thephantom8768/Phantom-Macro-Mk.1-Series/README.md

# Phantom Macro Mk.1 Series

> A modular, snap-together macropad ecosystem with lateral pogo-pin bus interconnects.

Chain modules side-by-side to expand your desktop workflow—from a compact macro-pad into a full fledge keyboard.

---

## 📌 Project Status

- **Hardware:** Series still in-dev
- **Firmware:** Pad is almost complete but I need to built it to measure the adc. Others are still in-dev
- **Interconnect:** Custom edge-mount 8 pin pogo interface.

---

## ⚡ Features

- **Snap & Chain Topology:** Expand your layout horizontally by mating adjacent modules using edge-mounted pogo connectors.
- **Unified Bus Standard:** Standardized power, ground, and communication rails allow any Mk.1-series compatible module to hot-mate with the system.
- **Flexible Layouts:** Mix and match different form factors (numpads, macro clusters, encoder dials) without rerunning separate USB cables to your host machine.

## ⚠️ Build Warnings

> [!WARNING]
> **DIY Soldering Required:** This is a fully self-assembled project. It is not a plug-and-play kit and requires intermediate soldering experience.

* **Double-Sided Assembly:** Depending on the macro-pad, components might need to be soldered onto **both the top and bottom** of the PCB.

## *Mk.1 Series*

<details>
  <summary><b>🔢 Phantom-Macro-Mk.1 Pad (click here)</b></summary>
  
  ### Macro Mk.1 Pad
  
  #### Schematic

Phantom Macro Mk1 Pad

#### PCB Layout

4 Layers PCB

<div style="width: max; height: max; overflow: hidden; display: inline-block;">
  <a href="Pics/Pad/Phantom Macro Mk1 Pad Schematic.png" target="_blank">
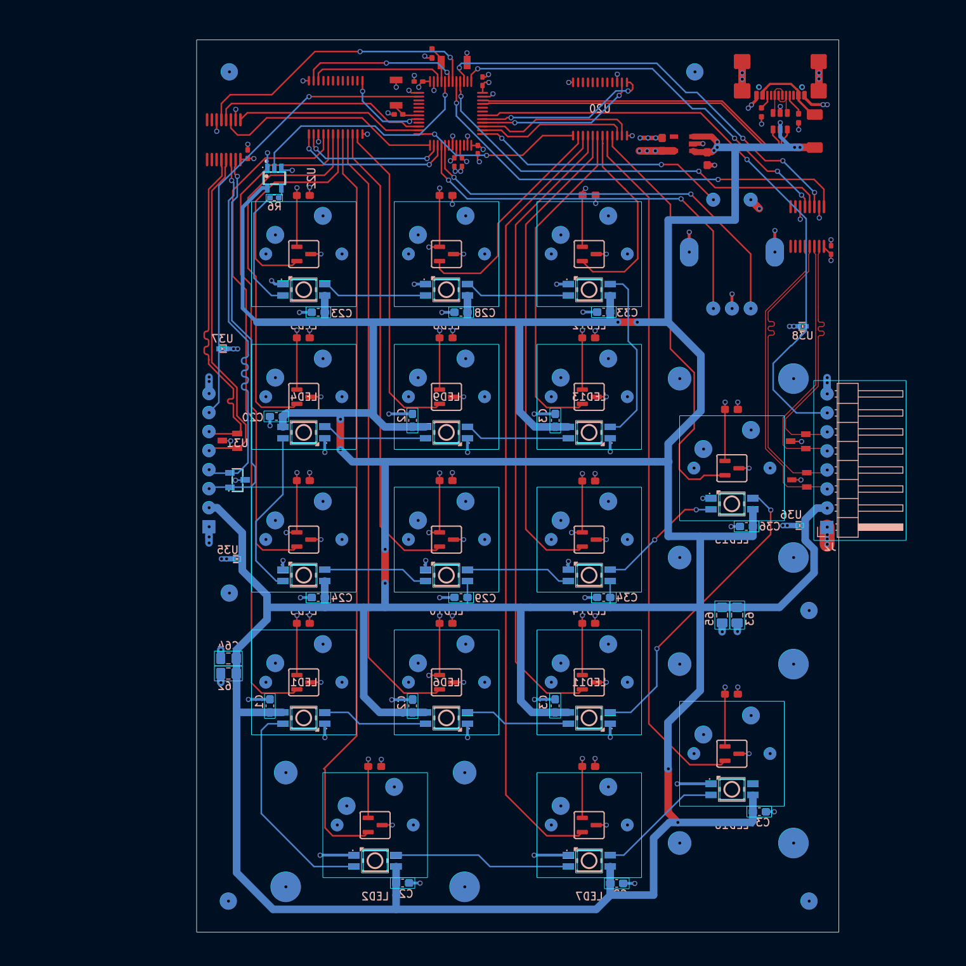
[picture p1: Pics/Pad/Phantom Macro Mk1 Pad Schematic.png]
    
  </a>
</div>

| Front (1st layer) | Bottom (4th layer) |
| --- | --- |
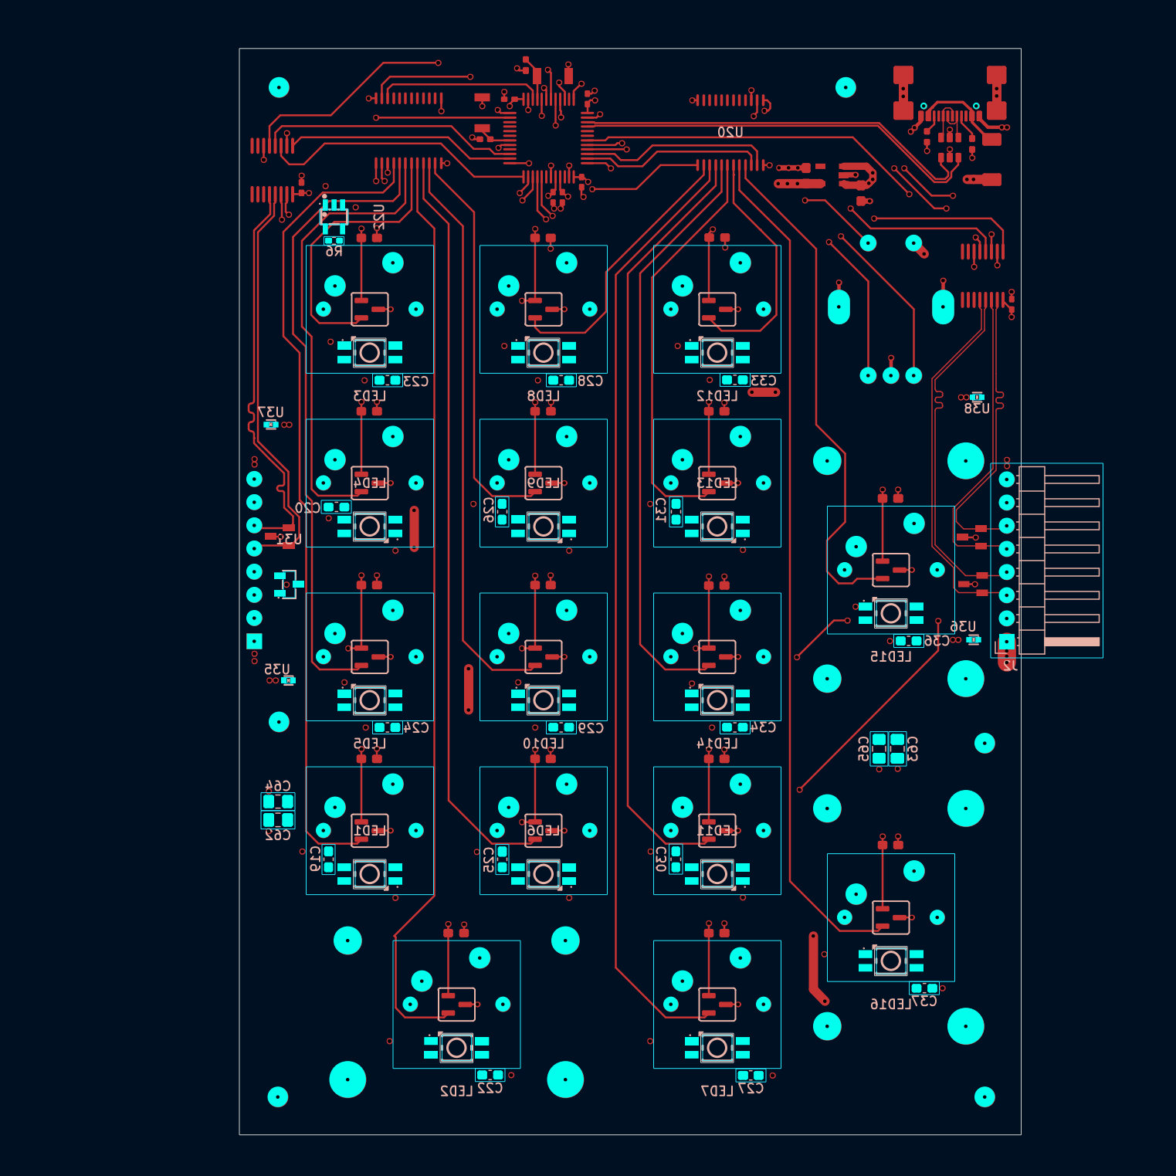
[picture p2: Pics/Pad/Phantom Macro Mk1 Pad Schematic Top.png]
Phantom Macro Mk1 pad Schematic Top
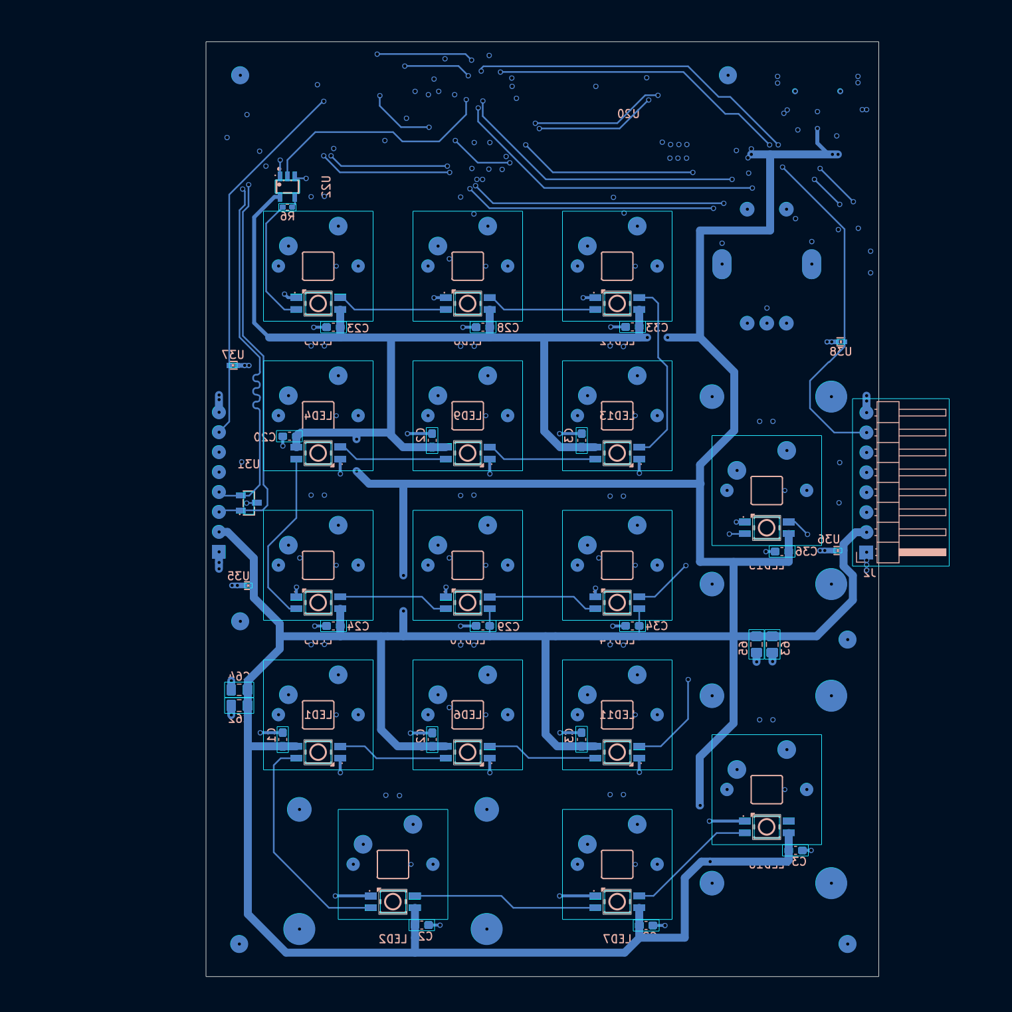
[picture p3: Pics/Pad/Phantom Macro Mk1 Pad Schematic Bottom.png]
Phantom Macro Mk1 Pad Schematic Bottom
|  |  |
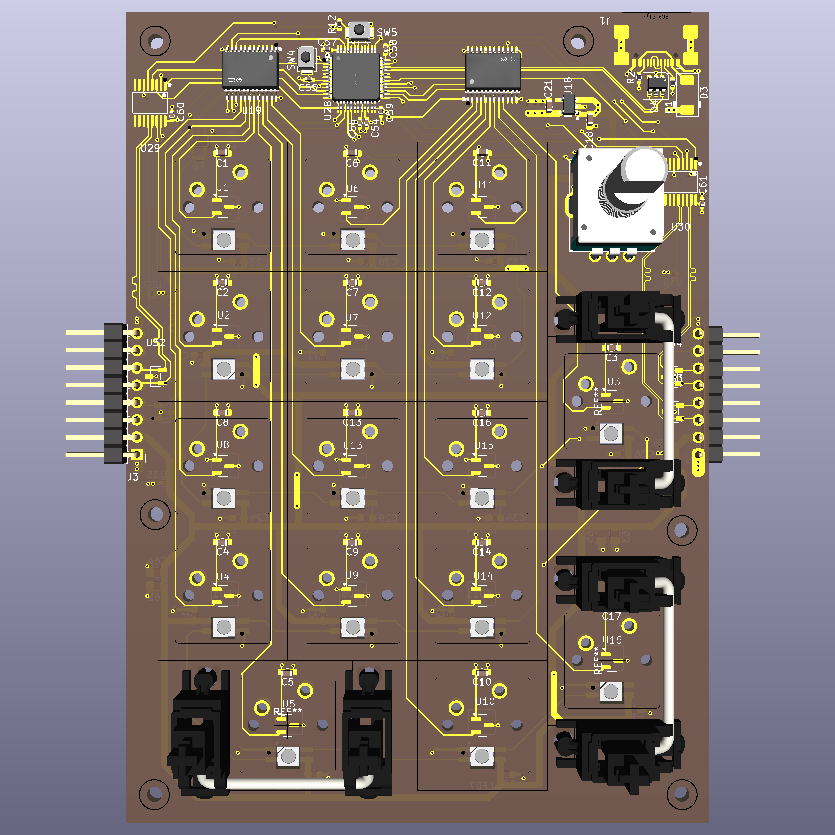
[picture p4: Pics/Pad/Phantom Macro Mk1 Pad Top Trace.png]
Phantom Macro Mk1 Pad Top Trace
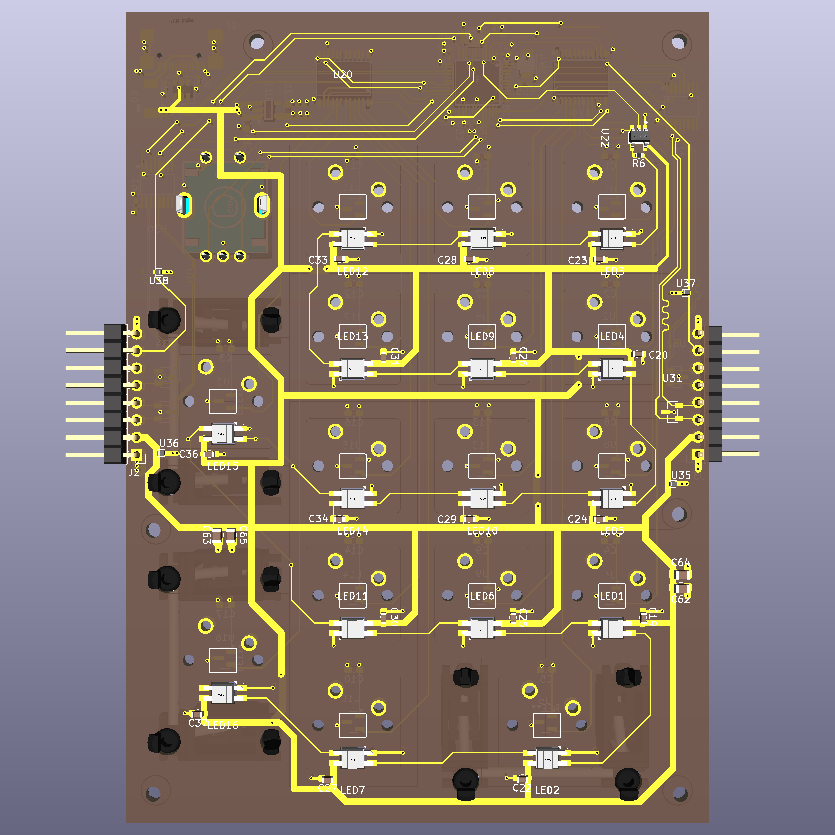
[picture p5: Pics/Pad/Phantom Macro Mk1 Pad Bottom Trace.png]
Phantom Macro Mk1 Pad Bottom Trace
|  |  |

#### PCB
| Front | Back |
| ----- | ---- |
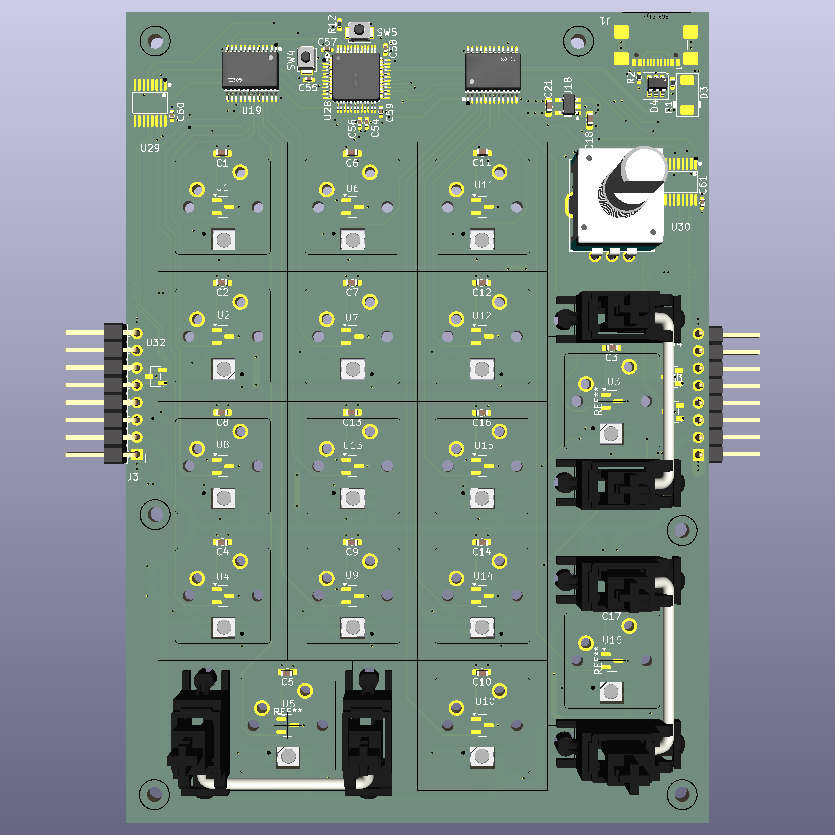
[picture p6: Pics/Pad/Phantom Macro Mk1 Pad Ortho3.png]
Phantom Macro Mk1 Ortho3
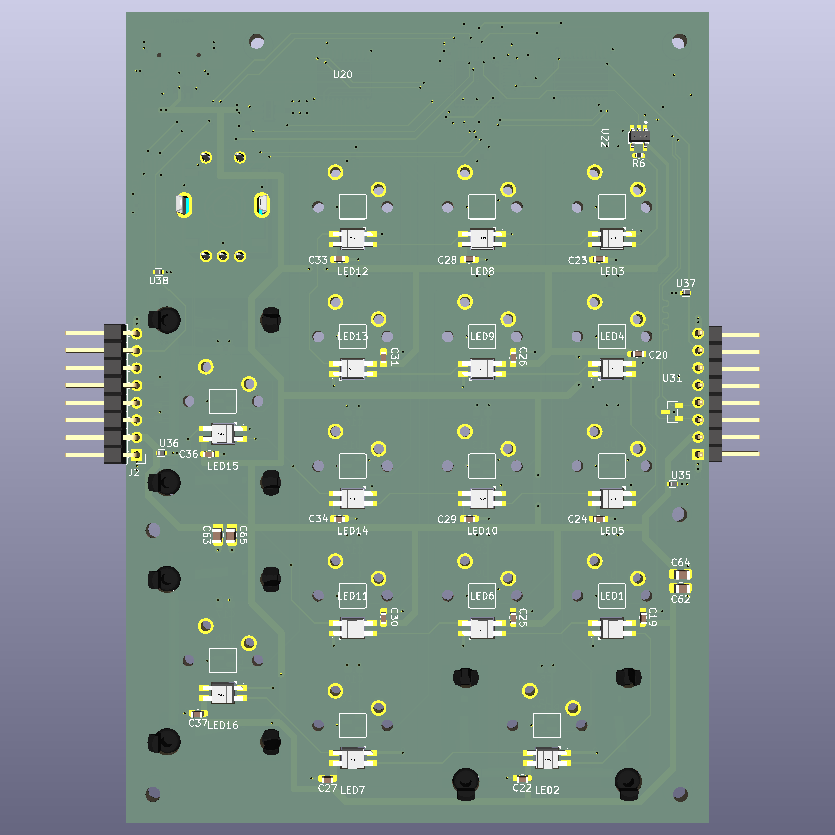
[picture p7: Pics/Pad/Phantom Macro Mk1 Pad Ortho4.png]
Phantom Macro Mk1 Ortho4
|  |  |
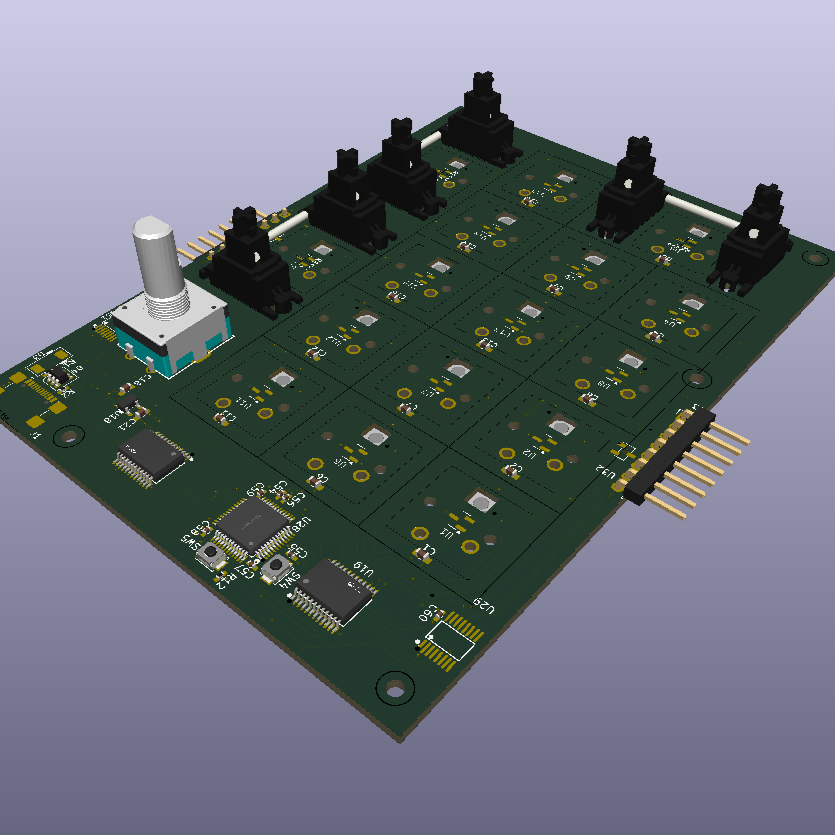
[picture p8: Pics/Pad/Phantom Macro Mk1 Pad Ortho1.png]
Phantom Macro Mk1 Ortho1
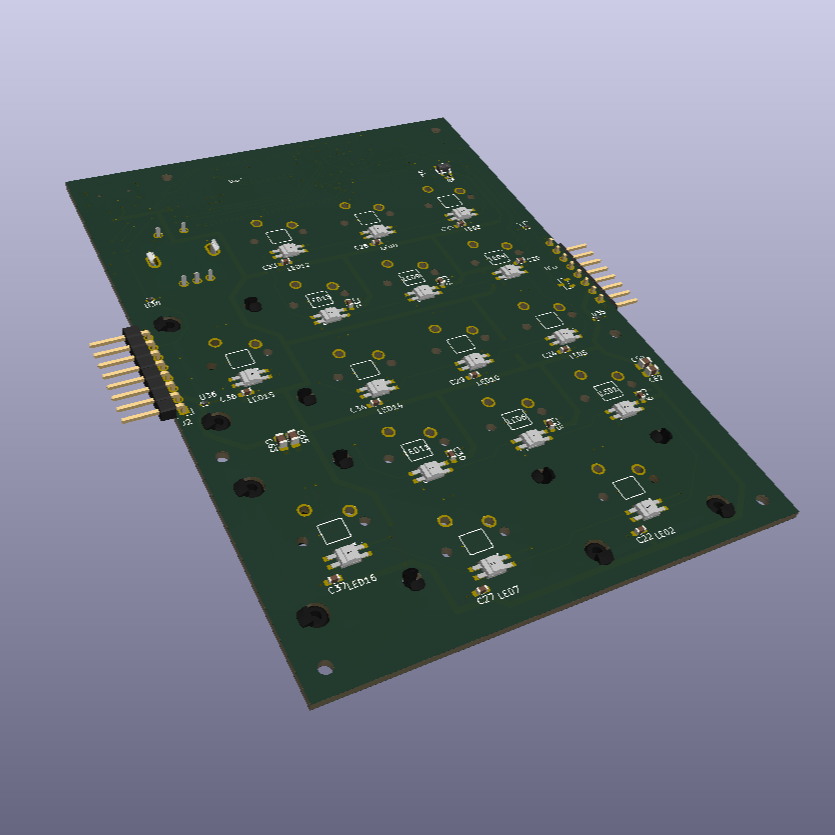
[picture p9: Pics/Pad/Phantom Macro Mk1 Pad Ortho2.png]
Phantom Macro Mk1 Ortho2
|  |  |

#### Case

<table>
  <tbody>
    <tr>
      <td width="50%">
        <a href="Pics/Pad/Case1.png" target="_blank">
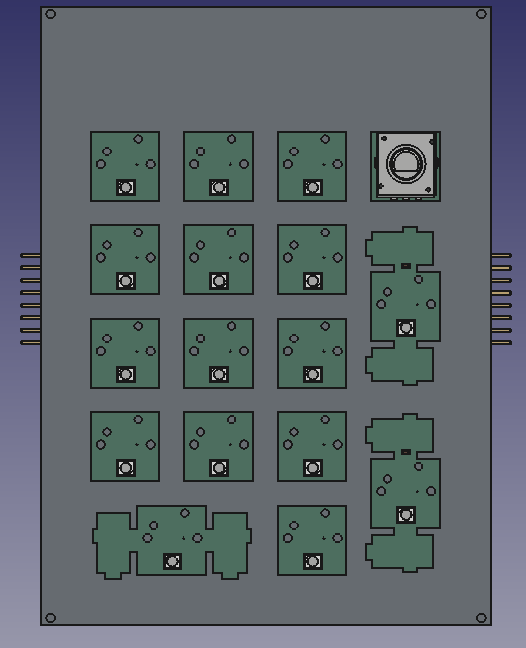
[picture p10: Pics/Pad/Case1.png]
Case 1 - Top Left
          
        </a>
      </td>
      <td width="50%">
        <a href="Pics/Pad/Case2.png" target="_blank">
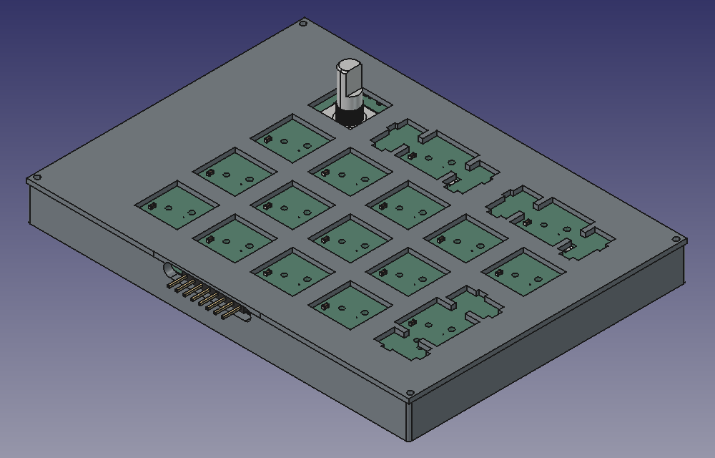
[picture p11: Pics/Pad/Case2.png]
Case 2 - Top Right
          
        </a>
      </td>
    </tr>
    <tr>
      <td width="50%">
        <a href="Pics/Pad/Case3.png" target="_blank">
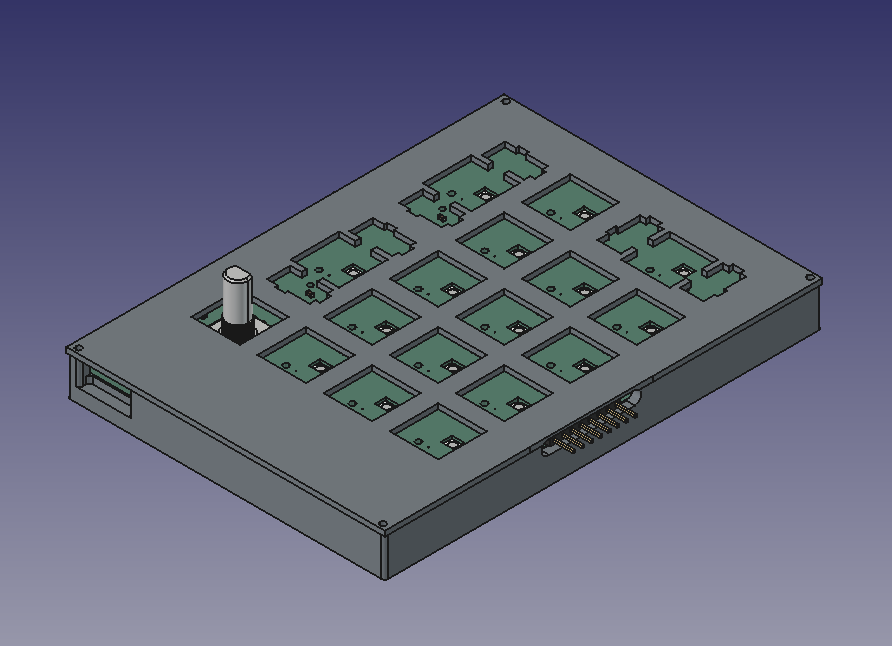
[picture p12: Pics/Pad/Case3.png]
Case 3 - Bottom Left
          
        </a>
      </td>
      <td width="50%">
        <a href="Pics/Pad/Case4.png" target="_blank">
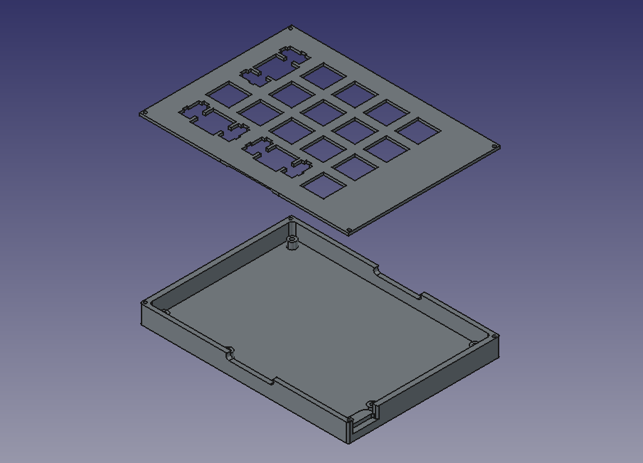
[picture p13: Pics/Pad/Case4.png]
Case 4 - Bottom Right
          
        </a>
      </td>
    </tr>
  </tbody>
</table>

</details>

<details>
  <summary><b>🎹 Phantom-Macro-Mk.1 MIDI (click here)</b></summary>
  
  ### Macro Mk.1 MIDI
  
  #### Schematic

  Phantom Macro Mk1 MIDI

  #### PCB Layout 

  2 Layers PCB
  
  Phantom Macro Mk1 MIDI Schematic

  | Front | Back |
  | ----- | ----- |
  | Phantom Macro Mk1 MIDI Schematic Top | PPhantom Macro Mk1 MIDI Schematic Bottom |
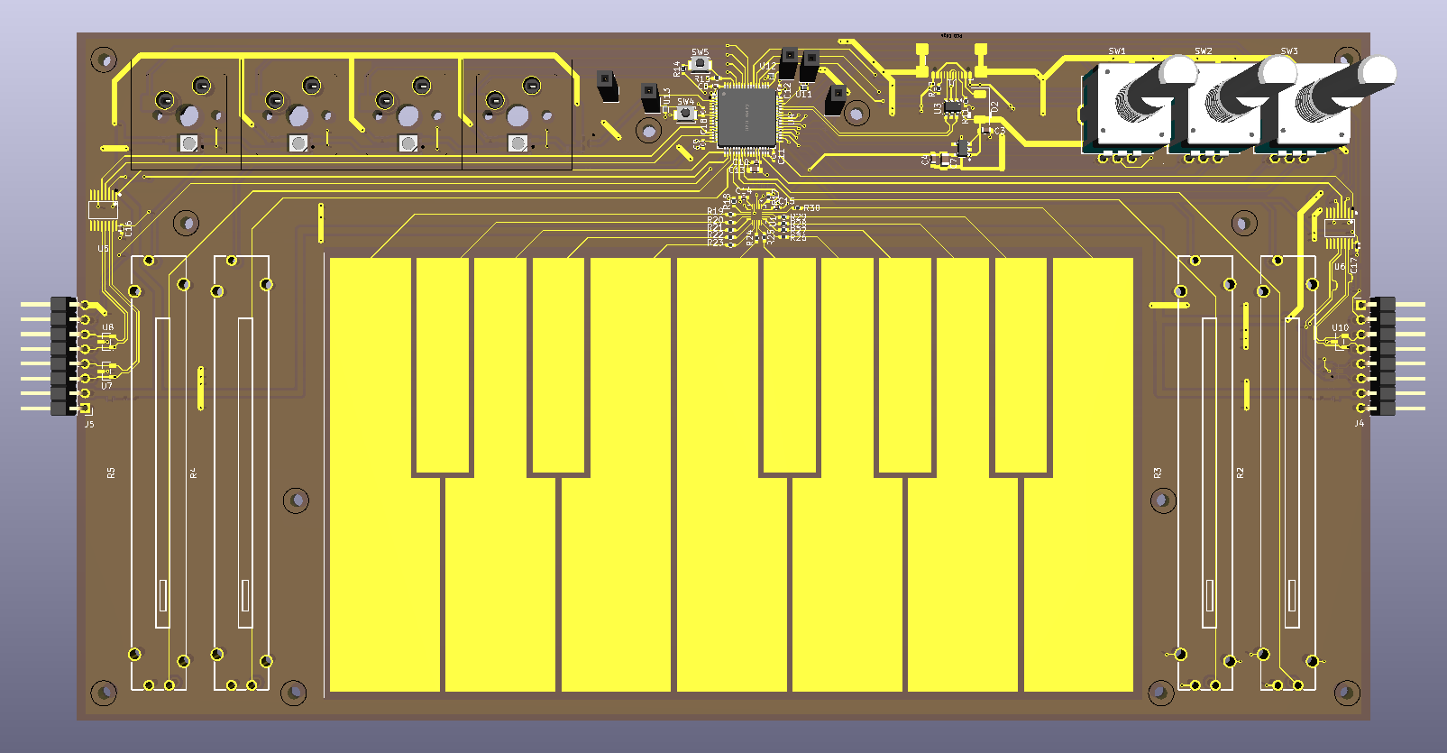
[picture p14: Pics/MIDI/Phantom Macro Mk1 MIDI Top Trace.png]
Phantom Macro Mk1 MIDI Top Trace
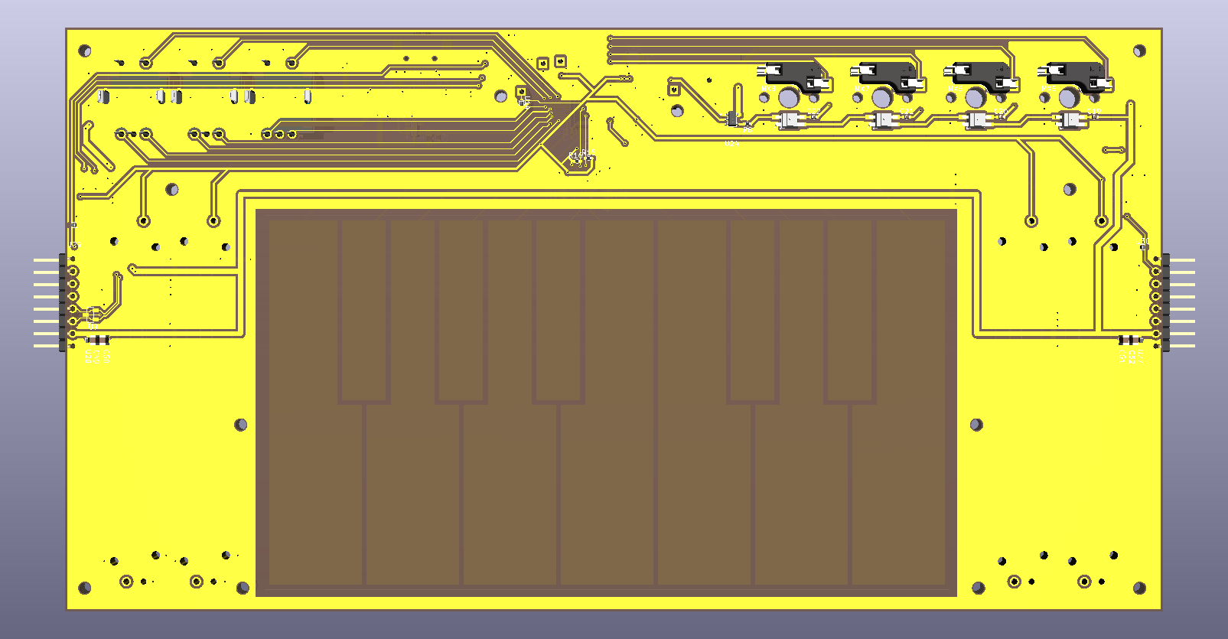
[picture p15: Pics/MIDI/Phantom Macro Mk1 MIDI Bottom Trace.png]
Phantom Macro Mk1 MIDI Bottom Trace
  |  |  |

  #### PCB
  | Front | Back |
  | ----- | ---- |
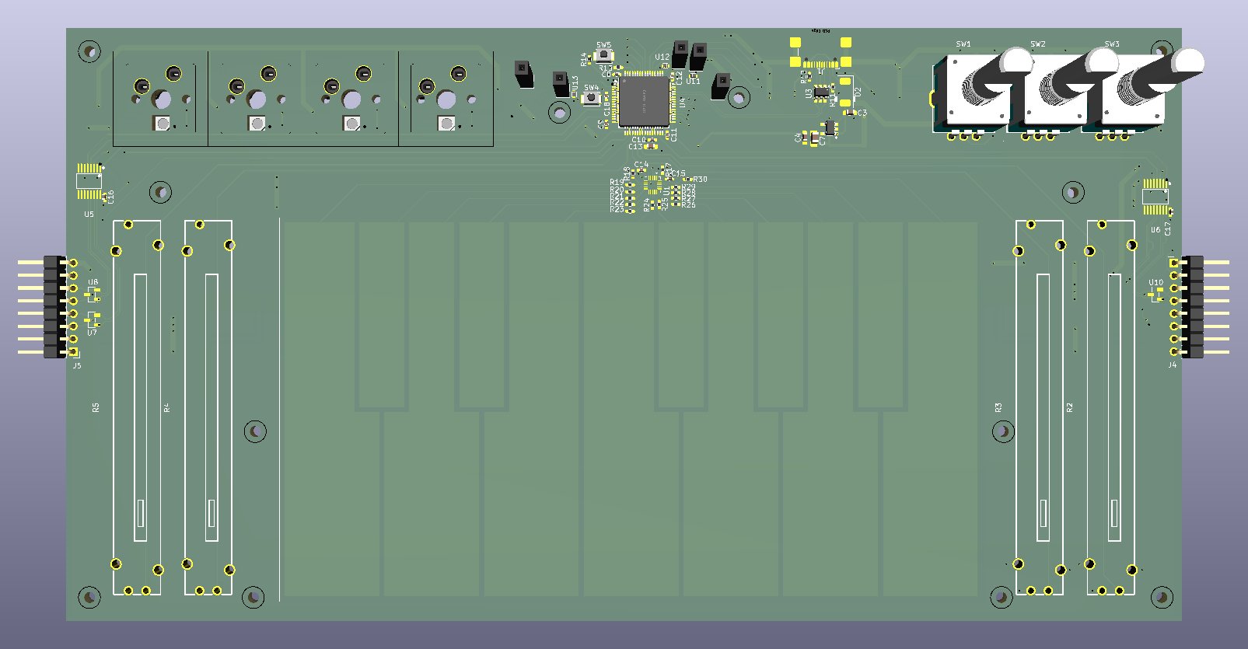
[picture p16: Pics/MIDI/Phantom Macro Mk1 MIDI Top.png]
Phantom Macro Mk1 MIDI Top
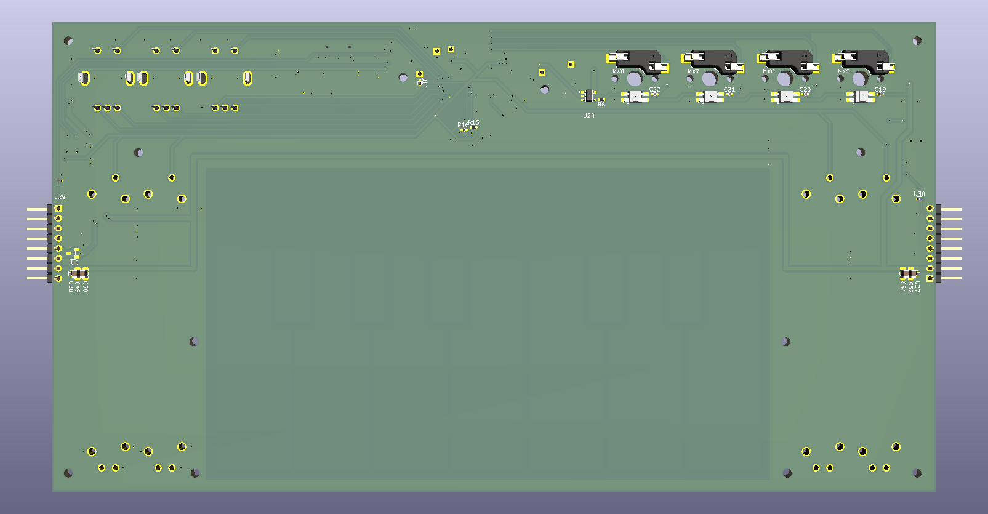
[picture p17: Pics/MIDI/Phantom Macro Mk1 MIDI Bottom.png]
Phantom Macro Mk1 MIDI Bottom
  |  |  |
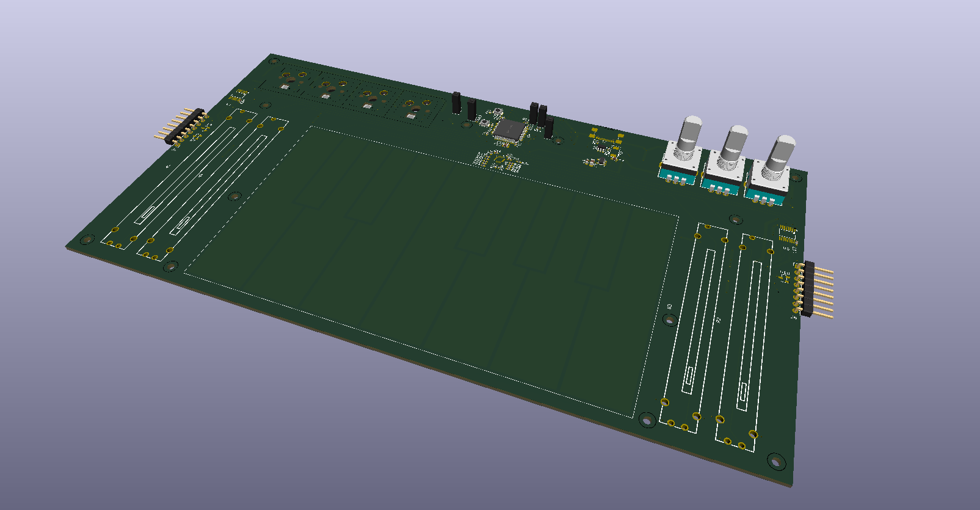
[picture p18: Pics/MIDI/Phantom Macro Mk1 MIDI ortho1.png]
Phantom Macro Mk1 MIDI ortho1
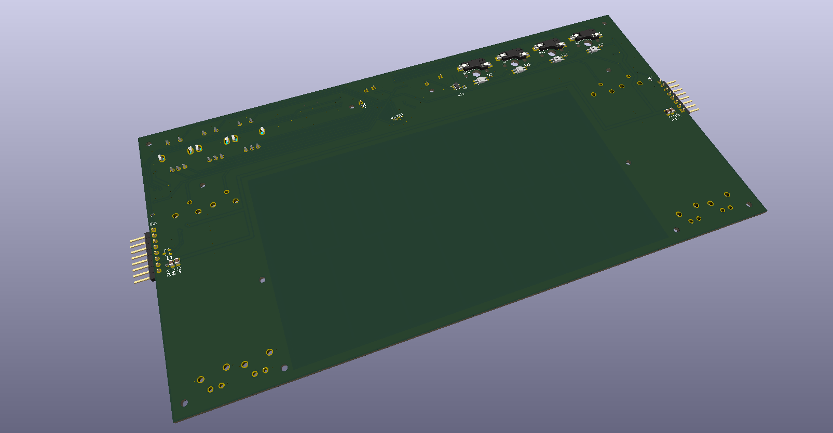
[picture p19: Pics/MIDI/Phantom Macro Mk1 MIDI ortho2.png]
Phantom Macro Mk1 MIDI ortho2
  |  |  |

</details>
