thephantom8768/Phantom-Macro-Mk.1-Series/Kicad Files/MIDI/Phantom Macro Mk1 MIDI.csv

Reference | Qty | Value | DNP | Exclude from BOM | Exclude from Board | Footprint | Datasheet
C3,C4,C13 | 3 | 1uF |  |  |  | Capacitor_SMD:C_0603_1608Metric_Pad1.08x0.95mm_HandSolder
C7 | 1 | 4.7uF |  |  |  | Capacitor_SMD:C_0805_2012Metric_Pad1.18x1.45mm_HandSolder
C8,C9,C10,C11,C12,C14,C15,C16,C17,C18,C19,C20,C21,C22 | 14 | 100nF |  |  |  | Capacitor_SMD:C_0402_1005Metric_Pad0.74x0.62mm_HandSolder
C49,C52 | 2 | 0.1uF |  |  |  | Capacitor_SMD:C_0805_2012Metric_Pad1.18x1.45mm_HandSolder
C50,C51 | 2 | 10uF |  |  |  | Capacitor_SMD:C_0805_2012Metric_Pad1.18x1.45mm_HandSolder
D2 | 1 | PMEG3030EP |  |  |  | PCM_Diode_SMD_AKL:D_SOD-128 | https://www.tme.eu/Document/abe71b1e3ae43c8e032df0d278a6f86a/PMEG3030EP.115.pdf
J1 | 1 | USB_C_Receptacle_USB2.0_16P |  |  |  | Connector_USB:USB_C_Receptacle_GCT_USB4110 | https://www.usb.org/sites/default/files/documents/usb_type-c.zip
J2 | 1 | Conn_01x12 |  |  |  | Piano:7 key piano tiles
J3,J6,J7,J8,J9 | 5 | Conn_01x01 |  |  |  | Connector_PinSocket_2.54mm:PinSocket_1x01_P2.54mm_Vertical
J4,J5 | 2 | Conn_01x08 |  |  |  | Connector_PinHeader_2.54mm:PinHeader_1x08_P2.54mm_Horizontal
LED1,LED2,LED3,LED4 | 4 | SK6803MINI-E-001 |  |  |  | lcsc_shared_footprints:C5242955_LED-SMD_4P-L3_2-W2_8_SK6803MINI-E-001 | https://wmsc.lcsc.com/wmsc/upload/file/pdf/v2/lcsc/2211011500_OPSCO-Optoelectronics-SK6803MINI-E-001_C5242955.pdf
MX5,MX6,MX7,MX8 | 4 | MX_SW_HS |  |  |  | PCM_marbastlib-mx:SW_MX_HS_CPG151101S11_1u
R2,R3,R4,R5 | 4 | PTA6043-2015DPA103 |  |  |  | lcsc_shared_footprints:C17237498_RES-ADJ-TH_PTA6043-XXXX | https://wmsc.lcsc.com/wmsc/upload/file/pdf/v2/lcsc/2311050146_BOURNS-PTA6043-2015DPA103_C17237498.pdf
R8 | 1 | 47R |  |  |  | Resistor_SMD:R_0402_1005Metric_Pad0.72x0.64mm_HandSolder
R11,R12 | 2 | 5.2k |  |  |  | Resistor_SMD:R_0402_1005Metric_Pad0.72x0.64mm_HandSolder
R13,R17,R18 | 3 | 10k |  |  |  | Resistor_SMD:R_0402_1005Metric_Pad0.72x0.64mm_HandSolder
R14 | 1 | 100 |  |  |  | Resistor_SMD:R_0402_1005Metric_Pad0.72x0.64mm_HandSolder
R15,R16 | 2 | 4.7k |  |  |  | Resistor_SMD:R_0402_1005Metric_Pad0.72x0.64mm_HandSolder
R19,R20,R21,R22,R23,R24,R25,R26,R27,R28,R29,R30 | 12 | 2k |  |  |  | Resistor_SMD:R_0402_1005Metric_Pad0.72x0.64mm_HandSolder
SW1,SW2,SW3 | 3 | PEC11R-4020F-S0024 |  |  |  | lcsc_shared_footprints:C143788_SW-TH_5P-L12_5-W13_4-P2_50-LS14_5 | https://www.lcsc.com/datasheet/lcsc_datasheet_2304140030_BOURNS-PEC11R-4020F-S0024_C143788.pdf
SW4,SW5 | 2 | SW_Push |  |  |  | Button_Switch_SMD:SW_SPST_B3U-1000P
U1 | 1 | MPR121QR2 |  |  |  | Package_DFN_QFN:UQFN-20_3x3mm_P0.4mm | https://resurgentsemi.com/wp-content/uploads/2018/09/MPR121_rev5-Resurgent.pdf?d453f8&d453f8
U2 | 1 | AP2112K-3.3TRG1 |  |  |  | lcsc_shared_footprints:C51118_SOT-25-5_L2_9-W1_6-P0_95-LS2_8-BL | https://www.lcsc.com/datasheet/lcsc_datasheet_2304140030_Diodes-Incorporated-AP2112K-3-3TRG1_C51118.pdf
U3 | 1 | USBLC6-2SC6 |  |  |  | Package_TO_SOT_SMD:SOT-23-6 | https://www.st.com/resource/en/datasheet/usblc6-2.pdf
U4 | 1 | STM32G431RBT6 |  |  |  | lcsc_shared_footprints:C431633_LQFP-64_L10_0-W10_0-P0_50-LS12_0-BL | https://www.lcsc.com/datasheet/lcsc_datasheet_1912111437_STMicroelectronics-STM32G431RBT6_C431633.pdf
U5,U6 | 2 | LTC2855CGN#PBF |  |  |  | lcsc_shared_footprints:C682796_SSOP-16_L4_9-W3_9-P0_64-LS6_0-BL | https://www.lcsc.com/datasheet/lcsc_datasheet_2304140030_Analog-Devices-LTC2855CGN-PBF_C682796.pdf
U7,U8,U9,U10 | 4 | CDSOT23-SM712_C5122012 |  |  |  | lcsc_shared_footprints:C5122012_SOT-23-3_L2_9-W1_3-P0_95-LS2_4-BR | https://wmsc.lcsc.com/wmsc/upload/file/pdf/v2/lcsc/2208031730_TECH-PUBLIC-CDSOT23-SM712_C5122012.pdf
U11,U12,U13,U14,U27,U28,U29,U30 | 8 | TPD1E10B06DPYR |  |  |  | lcsc_shared_footprints:C48260_X1SON-2_L1_0-W0_6-P0_65-BI-1 | https://www.lcsc.com/datasheet/lcsc_datasheet_1809050228_Texas-Instruments-TPD1E10B06DPYR_C48260.pdf
U24 | 1 | 74AHCT1G125QW5-7 |  |  |  | lcsc_shared_footprints:C3755013_SOT-753_L3_1-W1_7-P0_95-LS3_0-BR | https://wmsc.lcsc.com/wmsc/upload/file/pdf/v2/lcsc/2308101643_Diodes-Incorporated-74AHCT1G125QW5-7_C3755013.pdf
