thephantom8768/Phantom-Macro-Mk.1-Series/BOM.csv

Item | Qty | Supplier | Cost/item | Total Cost | link
1uF | 18 | TaoBao | $0.00 | $0.00 | https://item.taobao.com/item.htm?id=630712731066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
0.1uF | 16 | TaoBao | $0.00 | $0.00 | https://item.taobao.com/item.htm?id=731471380840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
100nF | 8 | TaoBao | $0.00 | $0.00 | https://item.taobao.com/item.htm?abbucket=0&id=733879274781&ns=1&skuId=6120921533745&xxc=taobaoSearch
10uF | 2 | TaoBao | $0.00 | $0.00 | https://item.taobao.com/item.htm?abbucket=0&id=977236759812&ns=1&skuId=5958414476976&xxc=taobaoSearch
0.1uF | 2 | TaoBao | $0.00 | $0.00 | https://item.taobao.com/item.htm?abbucket=0&id=730748325366&ns=1&skuId=6128339268979&xxc=taobaoSearch
PMEG3030EP | 1 | TaoBao | $0.36 | $0.36 | https://item.taobao.com/item.htm?abbucket=20&id=694578569169&ns=1&xxc=taobaoSearch
USBLC6-2SC6 | 1 | TaoBao | $0.23 | $0.23 | https://item.taobao.com/item.htm?id=763430084934
USB_C_Receptacle_USB2.0_16P | 1 | TaoBao | $0.08 | $0.08 | https://item.taobao.com/item.htm?id=591211481748
Conn_01x08 | 2 | TaoBao | $1.04 | $2.08 | https://item.taobao.com/item.htm?ali_trackid=318_42ec11eaf52e5fd050ce110009cc65aa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
SK6803MINI-E-001 | 16 | TaoBao | $0.04 | $0.64 | https://item.taobao.com/item.htm?id=1074492412694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
5.1k | 2 | TaoBao | $0.00 | $0.00 | https://item.taobao.com/item.htm?id=525633713781&skuId=5699327116853
47R | 1 | TaoBao | $0.00 | $0.00 | https://item.taobao.com/item.htm?id=525633713781&skuId=5699327116853
10k | 1 | TaoBao | $0.00 | $0.00 | https://item.taobao.com/item.htm?id=525633713781&skuId=5699327116853
PEC11R-4020F-S0024 | 1 | TaoBao | $3.54 | $3.54 | https://item.taobao.com/item.htm?id=755153501399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
SPST B3U-1000P | 2 | TaoBao | $0.10 | $0.20 | https://item.taobao.com/item.htm?id=1061900134323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
SW_MX_HE | 16 | Milktooth | $0.85 | $13.60 | https://milktooth.com/products/dove-he
AP2112K-3.3TRG1 | 1 | TaoBao | $0.55 | $0.55 | https://intl.taobao.com/sk/_b.OcKv5a
CD74HC4067SM96 | 2 | TaoBao | $0.35 | $0.70 | https://item.taobao.com/item.htm?id=659268510241
74AHCT1G125QW5-7 | 1 | TaoBao | $0.31 | $0.31 | https://item.taobao.com/item.htm?id=581190029859
STM32G431CBT6 | 1 | TaoBao | $3.67 | $3.67 | https://item.taobao.com/item.htm?id=662218011027
LTC2855CGN#PBF | 2 | AliXpress | $8.44 | $16.88 | https://a.aliexpress.com/_c40x90oj
CDSOT23-SM712_C5122012 | 4 | TaoBao | $0.05 | $0.20 | https://detail.tmall.com/item.htm?id=903941269382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
TPD1E10B06DPYR | 4 | TaoBao | $0.08 | $0.32 | https://item.taobao.com/item.htm?id=594637912684
DRV5055 | 16 | TaoBao | $0.94 | $15.04 | https://detail.tmall.com/item.htm?from=cart&id=660549060773&skuId=5097480923683&upStreamPrice=2000
PCB | 1 | JLCPCB | $29.30 | $29.30 | https://JLCPCB.com
Estimated total shipping | 1 |  |  | $7.13
