thephantom8768/Phantom-Macro-Mk.1-Series/3D Case/Pad/Phantom Macro Mk1 Pad.step

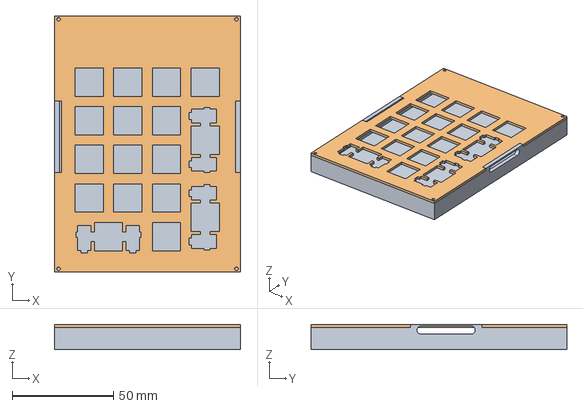
[picture p20: CAD file, 2026-11-04]
3D Case/Pad/Phantom Macro Mk1 Pad.step
91.7 x 126.1 x 12.5 mm
Mounting_plate
