thephantom8768/Phantom-Macro-Mk.1-Series/(list of files, cad)

Other CAD files:
3D Case/Pad/Phantom Macro Mk1 Pad.FCStd
3D Case/Pad/Phantom Macro Mk1 Pad.stl
