thephantom8768/Phantom-Macro-Mk.1-Series/JOURNAL.md

# Phantom Macro Mk.1: devlog

<!-- Generated by Half Life from project cmuwyl8mx002001rlbmdwee1s. Edits here are overwritten on the next sync. -->
<!-- Generated: 2026-11-03T17:28:59.783Z -->

> [!NOTE]
> This devlog is mirrored from [Half Life](https://halflife.hackclub.com) ([open the project](https://halflife.hackclub.com/projects/cmuwyl8mx002001rlbmdwee1s)). Editing it here will not change the platform's copy, and the next sync overwrites this file.

> My first ever macro pad! Ofc it must include RGB and Hall-effect switches 😉. It is also daisy chainable with other compatible gadgets i might make in the future!!!

| Week | Tier | Hours logged | Entries |
| --- | --- | --- | --- |
| Week 1 | Tier 2 | 20.1h | 6 |

## Contents

1. [2026-10-07: Had a brilliant idea! What if instead of just a normal macro-pad at the side, why not make it the main keyboard? So i thought about some of its features like modular connection between macro pads and](#2026-10-07-had-a-brilliant-idea-what-if-instead-of-just-a-no)
2. [2026-10-08: Work session](#2026-10-08-work-session)
3. [2026-10-09: Work session](#2026-10-09-work-session)
4. [2026-10-09: Work session](#2026-10-09-work-session)
5. [2026-10-11: Work session](#2026-10-11-work-session)
6. [2026-11-03: Work session](#2026-11-03-work-session)

## Design

### 2026-10-07: Had a brilliant idea! What if instead of just a normal macro-pad at the side, why not make it the main keyboard? So i thought about some of its features like modular connection between macro pads and

**2.67h**

Had a brilliant idea! What if instead of just a normal macro-pad at the side, why not make it the main keyboard? So i thought about some of its features like modular connection between macro pads and daisy-chaining them together.

I started by doing a little research on the components i did, then i got the symbol and footprint into Kicad. I had to make my own footprint for the Haimu Dove HE v2 switches as they are not available in any of the keyboard switches library. After that i placed them all into the schematic editor. Did some sanity check with AI and found out some components are not suitable so had to change them and think about extra features.



On the second day, i started a little work on the RP2040 mcu following the hardware design guide docs.



[Timelapse](https://lookout.hackclub.com/api/media/f96c17ed-fec7-4e81-aad1-caf7c4a13347/video.mp4)

[Timelapse](https://lookout.hackclub.com/api/media/adab5b6f-9ecc-49dc-8dc8-3c099ccf78f4/video.mp4)

### 2026-10-08: Work session

**4.15h**

[Timelapse](https://lookout.hackclub.com/api/media/1d86ae5d-aeba-4867-b1ac-ec53e2aa67dc/video.mp4)

### 2026-10-09: Work session

**3.92h**

[Timelapse](https://lookout.hackclub.com/api/media/eff3a2f3-d6fb-4b21-9e9d-972cb0128b21/video.mp4)

### 2026-10-09: Work session

**3.03h**

[Timelapse](https://lookout.hackclub.com/api/media/d0b9a1c6-1c95-4988-8c52-6c15b48cc5ee/video.mp4)

### 2026-10-11: Work session

**1.25h**

[Timelapse](https://lookout.hackclub.com/api/media/96e64c87-cb77-4474-81e8-4e0974f66a05/video.mp4)

[Timelapse](https://lookout.hackclub.com/api/media/57d2b1e9-1897-4735-b813-1c9f5ffc207c/video.mp4)

### 2026-11-03: Work session

**5.08h**

[Timelapse](https://lookout.hackclub.com/api/media/ad5cc039-fe3e-4b93-8cf1-e8fb28cdf246/video.mp4)

[Timelapse](https://lookout.hackclub.com/api/media/5f6dcd97-16b0-44fe-9f77-f1dbbcfa1bf2/video.mp4)
