thephantom8768/Phantom-Macro-Mk.1-Series/Pics/MIDI/Phantom Macro Mk1 MIDI Schematic Bottom.pdf

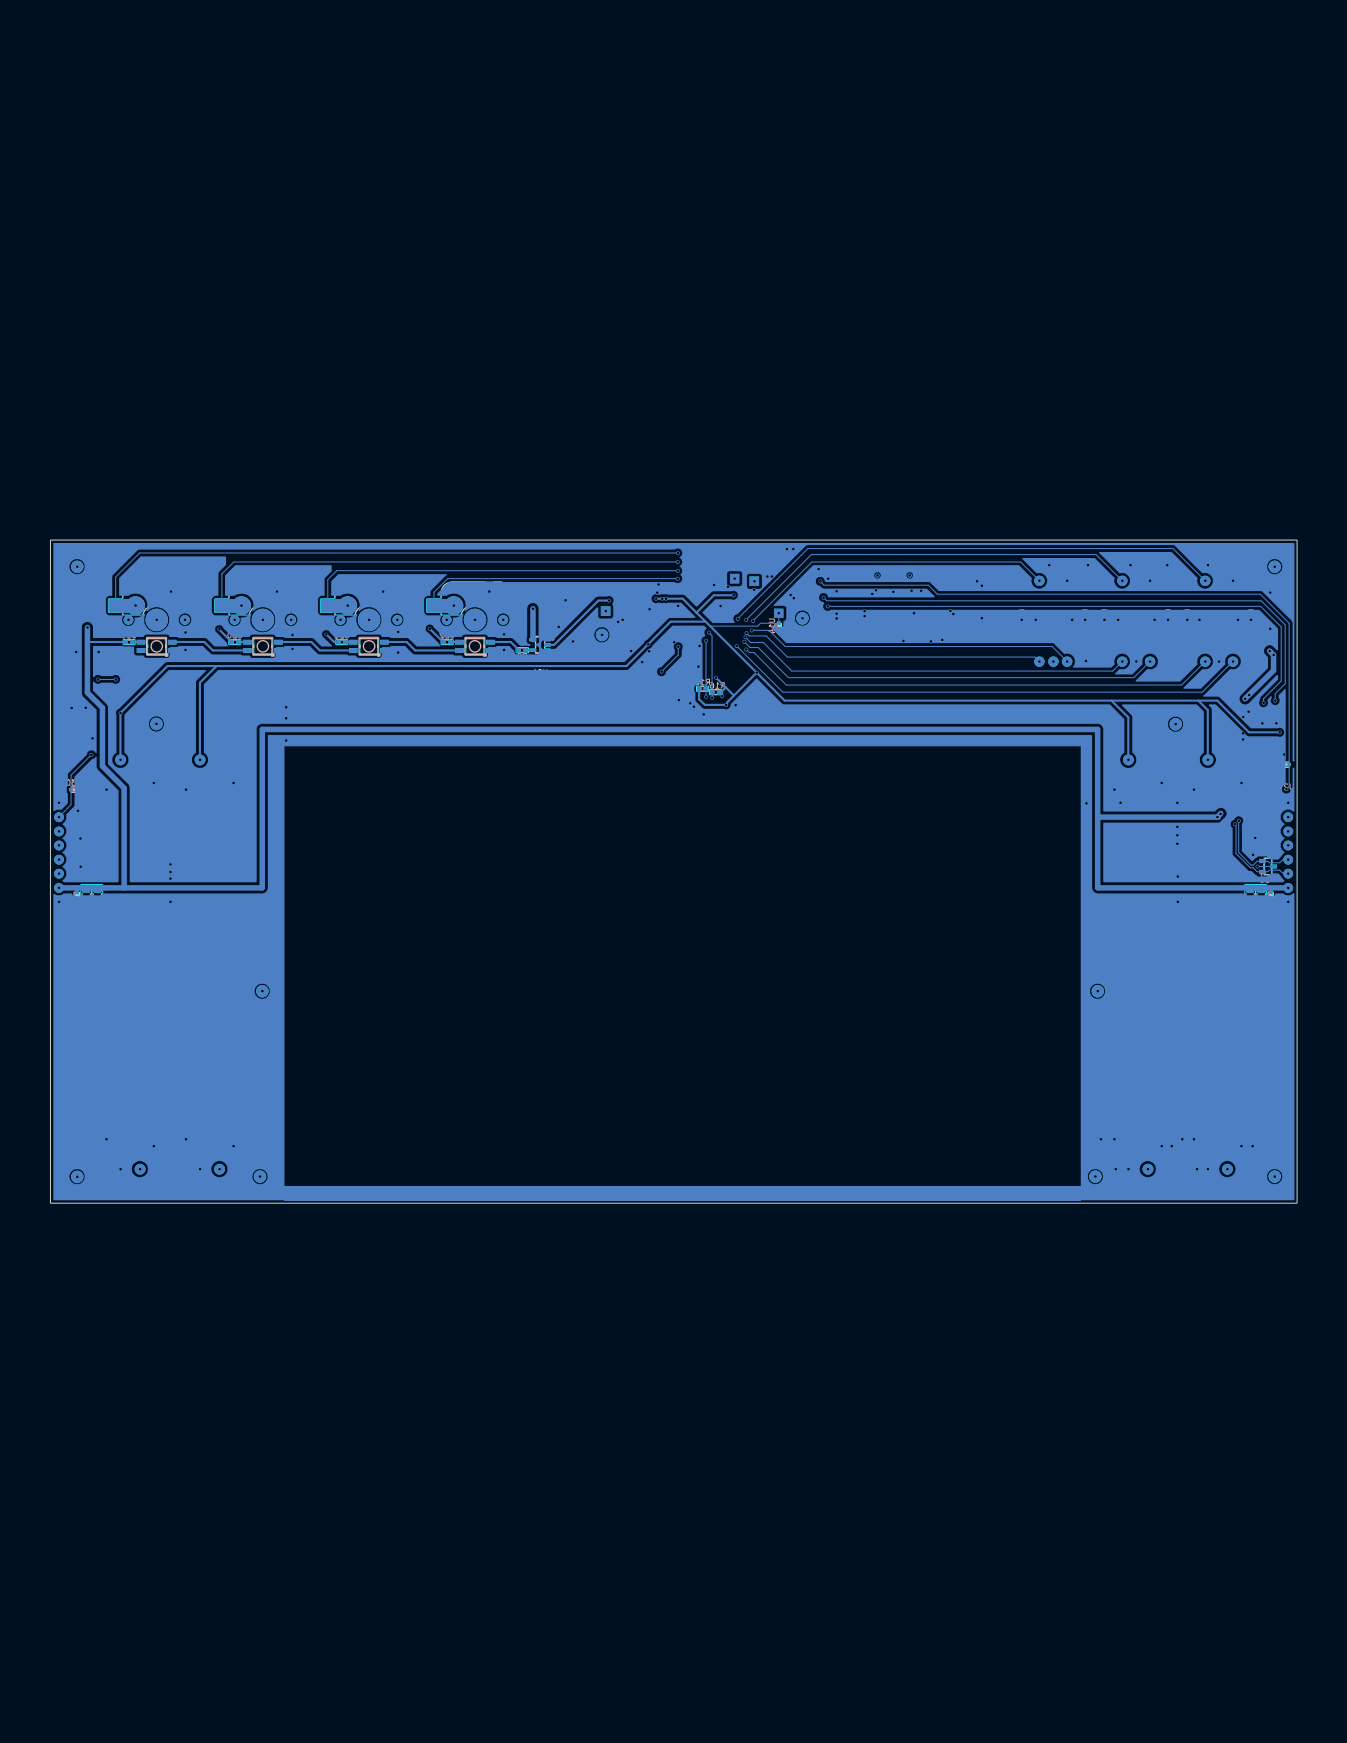
[picture p21: page 1]
