thephantom8768/Phantom-Macro-Mk.1-Series/Pics/MIDI/Phantom Macro Mk1 MIDI Schematic Top.pdf

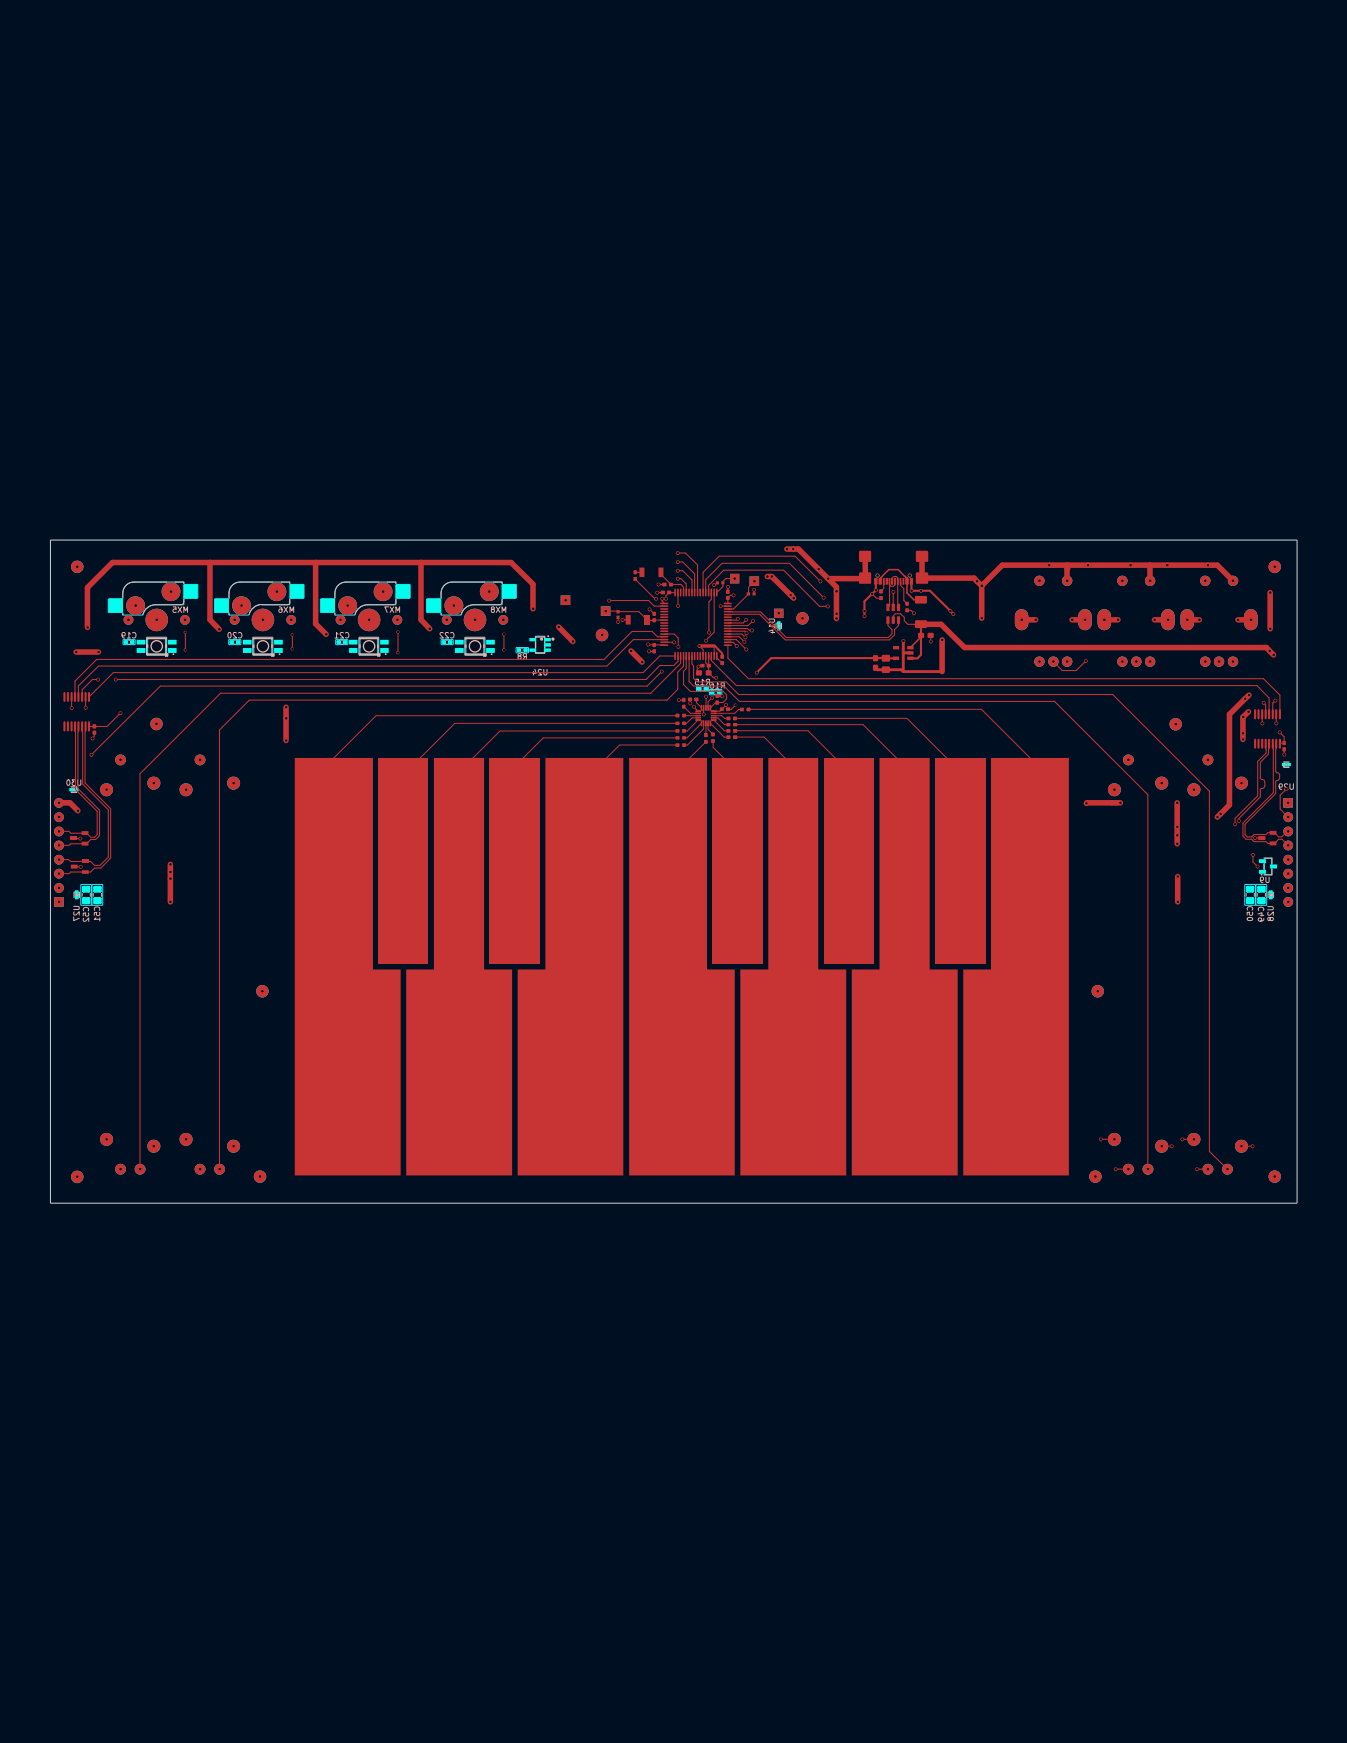
[picture p22: page 1]
