thephantom8768/Phantom-Macro-Mk.1-Series/Pics/MIDI/Phantom Macro Mk1 MIDI Schematic.pdf

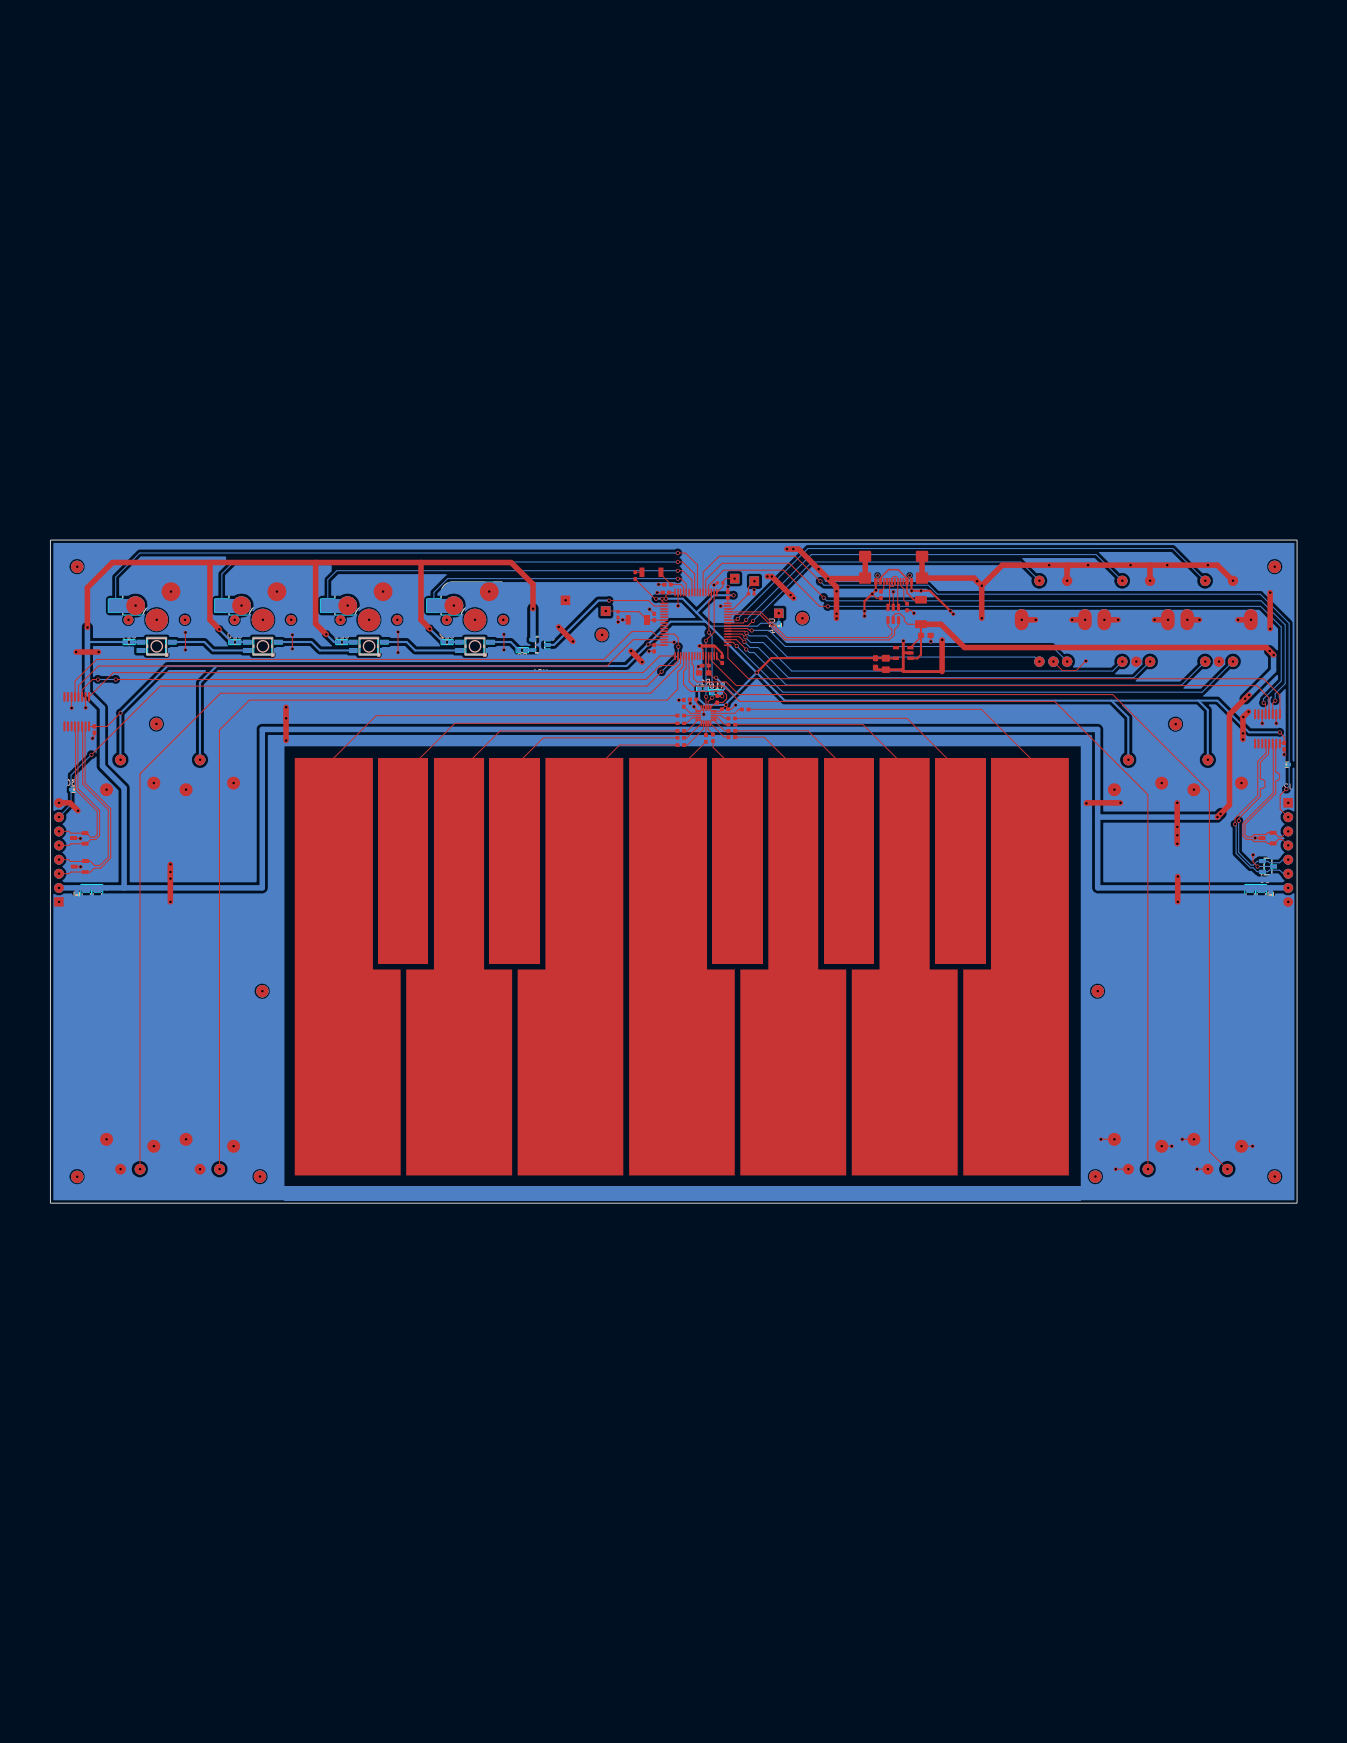
[picture p23: page 1]
