thephantom8768/Phantom-Macro-Mk.1-Series/Kicad Files/MIDI/Phantom Macro Mk1 MIDI.kicad_pcb

## KiCad design Kicad Files/MIDI/Phantom Macro Mk1 MIDI.kicad_pcb (2026-11-10)

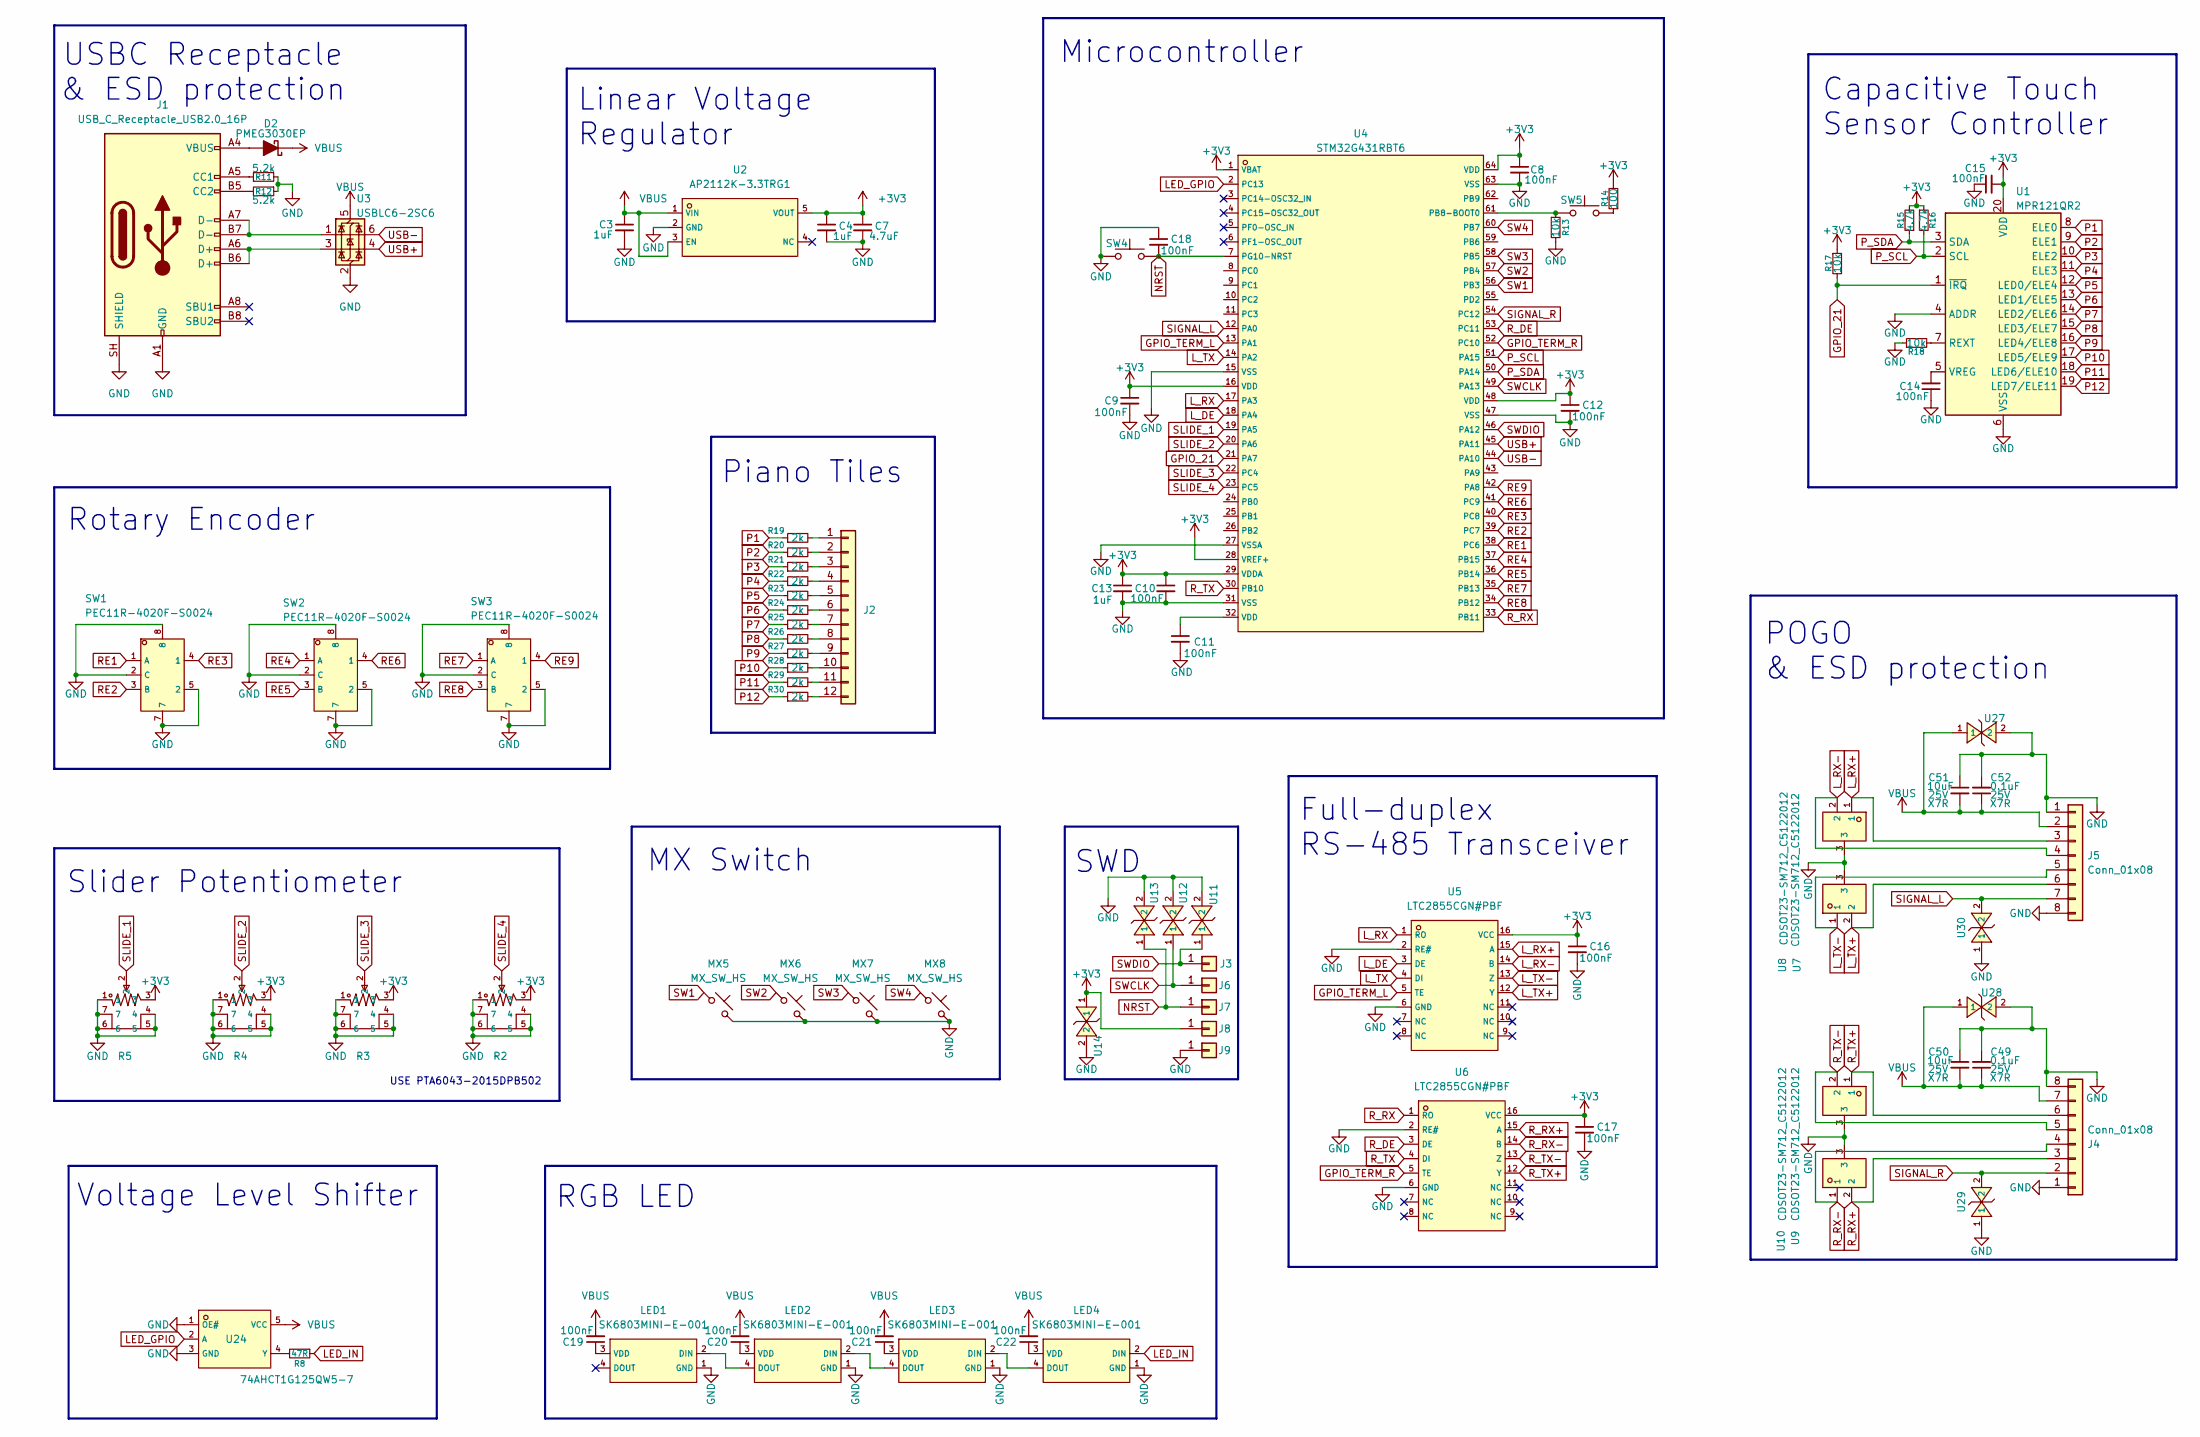
[picture p24: schematic Phantom Macro Mk1 MIDI.kicad_sch]

Parts:
C3, C4, C13: 1uF; C_0603_1608Metric_Pad1.08x0.95mm_HandSolder
C7: 4.7uF; C_0805_2012Metric_Pad1.18x1.45mm_HandSolder
C8, C9, C10, C11, C12, C14, C15, C16, C17, C18, C19, C20, C21, C22: 100nF; C_0402_1005Metric_Pad0.74x0.62mm_HandSolder
C49, C52: 0.1uF; C_0805_2012Metric_Pad1.18x1.45mm_HandSolder; Rating 25V
C50, C51: 10uF; C_0805_2012Metric_Pad1.18x1.45mm_HandSolder; Rating 25V
D2: PMEG3030EP; D_SOD-128
J1: USB_C_Receptacle_USB2.0_16P; USB_C_Receptacle_GCT_USB4110
J2: Conn_01x12; 7 key piano tiles
J3, J6, J7, J8, J9: Conn_01x01; PinSocket_1x01_P2.54mm_Vertical
J4, J5: Conn_01x08; PinHeader_1x08_P2.54mm_Horizontal
LED1, LED2, LED3, LED4: SK6803MINI-E-001; C5242955_LED-SMD_4P-L3_2-W2_8_SK6803MINI-E-001; LCSC C5242955
MX5, MX6, MX7, MX8: MX_SW_HS; SW_MX_HS_CPG151101S11_1u
R2, R3, R4, R5: PTA6043-2015DPA103; C17237498_RES-ADJ-TH_PTA6043-XXXX; LCSC C17237498
R8: 47R; R_0402_1005Metric_Pad0.72x0.64mm_HandSolder
R11, R12: 5.2k; R_0402_1005Metric_Pad0.72x0.64mm_HandSolder
R13, R17, R18: 10k; R_0402_1005Metric_Pad0.72x0.64mm_HandSolder
R14: 100; R_0402_1005Metric_Pad0.72x0.64mm_HandSolder
R15, R16: 4.7k; R_0402_1005Metric_Pad0.72x0.64mm_HandSolder
R19, R20, R21, R22, R23, R24, R25, R26, R27, R28, R29, R30: 2k; R_0402_1005Metric_Pad0.72x0.64mm_HandSolder
SW1, SW2, SW3: PEC11R-4020F-S0024; C143788_SW-TH_5P-L12_5-W13_4-P2_50-LS14_5; LCSC C143788
SW4, SW5: SW_Push; SW_SPST_B3U-1000P
U1: MPR121QR2; UQFN-20_3x3mm_P0.4mm
U2: AP2112K-3.3TRG1; C51118_SOT-25-5_L2_9-W1_6-P0_95-LS2_8-BL; LCSC C51118
U3: USBLC6-2SC6; SOT-23-6
U4: STM32G431RBT6; C431633_LQFP-64_L10_0-W10_0-P0_50-LS12_0-BL; LCSC C431633
U5, U6: LTC2855CGN#PBF; C682796_SSOP-16_L4_9-W3_9-P0_64-LS6_0-BL; LCSC C682796
U7, U8, U9, U10: CDSOT23-SM712_C5122012; C5122012_SOT-23-3_L2_9-W1_3-P0_95-LS2_4-BR; LCSC C5122012
U11, U12, U13, U14, U27, U28, U29, U30: TPD1E10B06DPYR; C48260_X1SON-2_L1_0-W0_6-P0_65-BI-1; LCSC C48260
U24: 74AHCT1G125QW5-7; C3755013_SOT-753_L3_1-W1_7-P0_95-LS3_0-BR; LCSC C3755013

Connections:
+3V3: C4.1, C7.1, C8.1, C9.1, C10.1, C12.1, C13.1, C15.2, C16.1, C17.1, J8.1 (Pin_1_1), R2.3, R3.3, R4.3, R5.3, R14.2, R15.2, R16.1, R17.1, U1.20 (VDD), U2.5 (VOUT), U4.1 (VBAT), U4.16 (VDD), U4.28 (VREF+), U4.29 (VDDA), U4.48 (VDD), U4.64 (VDD), U5.16 (VCC), U6.16 (VCC), U14.1
GND: C3.2, C4.2, C7.2, C8.2, C9.2, C10.2, C11.2, C12.2, C13.2, C14.1, C15.1, C16.2, C17.2, C18.1, C49.2, C50.1, C51.1, C52.2, J1.A1 (GND), J1.A12 (GND), J1.B1 (GND), J1.B12 (GND), J1.SH (SHIELD), J4.1, J4.8, J5.1, J5.8, J9.1 (Pin_1_1), LED1.1 (GND), LED2.1 (GND), LED3.1 (GND), LED4.1 (GND), MX5.2, MX6.2, MX7.2, MX8.2, R2.1, R2.4, R2.5, R2.6, R2.7, R3.1, R3.4, R3.5, R3.6, R3.7, R4.1, R4.4, R4.5, R4.6, R4.7, R5.1, R5.4, R5.5, R5.6, R5.7, R11.2, R12.1, R13.2, R18.1, SW1.2 (C), SW1.5 (2), SW1.7, SW1.8, SW2.2 (C), SW2.5 (2), SW2.7, SW2.8, SW3.2 (C), SW3.5 (2), SW3.7, SW3.8, SW4.1, U1.4 (ADDR), U1.6 (VSS), U2.2 (GND), U3.2 (GND), U4.15 (VSS), U4.27 (VSSA), U4.31 (VSS), U4.47 (VSS), U4.63 (VSS), U5.2 (RE#), U5.6 (GND), U6.2 (RE#), U6.6 (GND), U7.3, U8.3, U9.3, U10.3, U11.2, U12.2, U13.2, U14.2, U24.1 (OE#), U24.3 (GND), U27.2, U28.2, U29.1, U30.1
GPIO_21: R17.2, U1.1 (~IRQ), U4.21 (PA7)
GPIO_TERM_L: U4.13 (PA1), U5.5 (TE)
GPIO_TERM_R: U4.52 (PC10), U6.5 (TE)
LED_GPIO: U4.2 (PC13), U24.2 (A)
LED_IN: LED4.2 (DIN), R8.1
L_DE: U4.18 (PA4), U5.3 (DE)
L_RX: U4.17 (PA3), U5.1 (RO)
L_RX+: J5.3, U5.15 (A), U7.1
L_RX-: J5.4, U5.14 (B), U7.2
L_TX: U4.14 (PA2), U5.4 (DI)
L_TX+: J5.6, U5.12 (Y), U8.2
L_TX-: J5.5, U5.13 (Z), U8.1
NRST: C18.2, J7.1 (Pin_1_1), SW4.2, U4.7 (PG10-NRST), U13.1
unnamed: C11.1, U4.32 (VDD)
unnamed: D2.2 (A), J1.A4 (VBUS), J1.A9 (VBUS), J1.B4 (VBUS), J1.B9 (VBUS)
unnamed: J1.A5 (CC1), R11.1
unnamed: J1.B5 (CC2), R12.2
unnamed: J1.A6 (D+), J1.B6 (D+), U3.3 (I/O2)
unnamed: J1.A7 (D-), J1.B7 (D-), U3.1 (I/O1)
unnamed: J2.1, R19.2
unnamed: J2.2, R20.2
unnamed: J2.3, R21.2
unnamed: J2.4, R22.2
unnamed: J2.5, R23.2
unnamed: J2.6, R24.2
unnamed: J2.7, R25.2
unnamed: J2.8, R26.2
unnamed: J2.9, R27.2
unnamed: J2.10, R28.2
unnamed: J2.11, R29.2
unnamed: J2.12, R30.2
unnamed: LED1.2 (DIN), LED2.4 (DOUT)
unnamed: C19.1, LED1.3 (VDD)
unnamed: LED2.2 (DIN), LED3.4 (DOUT)
unnamed: C20.1, LED2.3 (VDD)
unnamed: LED3.2 (DIN), LED4.4 (DOUT)
unnamed: C21.1, LED3.3 (VDD)
unnamed: C22.1, LED4.3 (VDD)
unnamed: R14.1, SW5.2
unnamed: R18.2, U1.7 (REXT)
unnamed: C14.2, U1.5 (VREG)
unnamed: R13.1, SW5.1, U4.61 (PB8-BOOT0)
unnamed: R8.2, U24.4 (Y)
P1: R19.1, U1.8 (ELE0)
P2: R20.1, U1.9 (ELE1)
P3: R21.1, U1.10 (ELE2)
P4: R22.1, U1.11 (ELE3)
P5: R23.1, U1.12 (LED0/ELE4)
P6: R24.1, U1.13 (LED1/ELE5)
P7: R25.1, U1.14 (LED2/ELE6)
P8: R26.1, U1.15 (LED3/ELE7)
P9: R27.1, U1.16 (LED4/ELE8)
P10: R28.1, U1.17 (LED5/ELE9)
P11: R29.1, U1.18 (LED6/ELE10)
P12: R30.1, U1.19 (LED7/ELE11)
P_SCL: R16.2, U1.2 (SCL), U4.51 (PA15)
P_SDA: R15.1, U1.3 (SDA), U4.50 (PA14)
RE1: SW1.1 (A), U4.38 (PC6)
RE2: SW1.3 (B), U4.39 (PC7)
RE3: SW1.4 (1), U4.40 (PC8)
RE4: SW2.1 (A), U4.37 (PB15)
RE5: SW2.3 (B), U4.36 (PB14)
RE6: SW2.4 (1), U4.41 (PC9)
RE7: SW3.1 (A), U4.35 (PB13)
RE8: SW3.3 (B), U4.34 (PB12)
RE9: SW3.4 (1), U4.42 (PA8)
R_DE: U4.53 (PC11), U6.3 (DE)
R_RX: U4.33 (PB11), U6.1 (RO)
R_RX+: J4.3, U6.15 (A), U10.2
R_RX-: J4.4, U6.14 (B), U10.1
R_TX: U4.30 (PB10), U6.4 (DI)
R_TX+: J4.6, U6.12 (Y), U9.1
R_TX-: J4.5, U6.13 (Z), U9.2
SIGNAL_L: J5.7, U4.12 (PA0), U30.2
SIGNAL_R: J4.2, U4.54 (PC12), U29.2
SLIDE_1: R5.2, U4.19 (PA5)
SLIDE_2: R4.2, U4.20 (PA6)
SLIDE_3: R3.2, U4.22 (PC4)
SLIDE_4: R2.2, U4.23 (PC5)
SW1: MX5.1, U4.56 (PB3)
SW2: MX6.1, U4.57 (PB4)
SW3: MX7.1, U4.58 (PB5)
SW4: MX8.1, U4.60 (PB7)
SWCLK: J6.1 (Pin_1_1), U4.49 (PA13), U12.1
SWDIO: J3.1 (Pin_1_1), U4.46 (PA12), U11.1
USB+: U3.4 (I/O2), U4.45 (PA11)
USB-: U3.6 (I/O1), U4.44 (PA10)
VBUS: C3.1, C19.2, C20.2, C21.2, C22.2, C49.1, C50.2, C51.2, C52.1, D2.1 (K), J4.7, J5.2, U2.1 (VIN), U2.3 (EN), U3.5 (VBUS), U24.5 (VCC), U27.1, U28.1

Notes on the sheet:
Voltage Level Shifter
Full-duplex RS-485 Transceiver
MX Switch
Slider Potentiometer
Piano Tiles
USE PTA6043-2015DPB502
Microcontroller
POGO & ESD protection
Capacitive Touch Sensor Controller
SWD
RGB LED
Rotary Encoder
Linear Voltage Regulator
USBC Receptacle & ESD protection

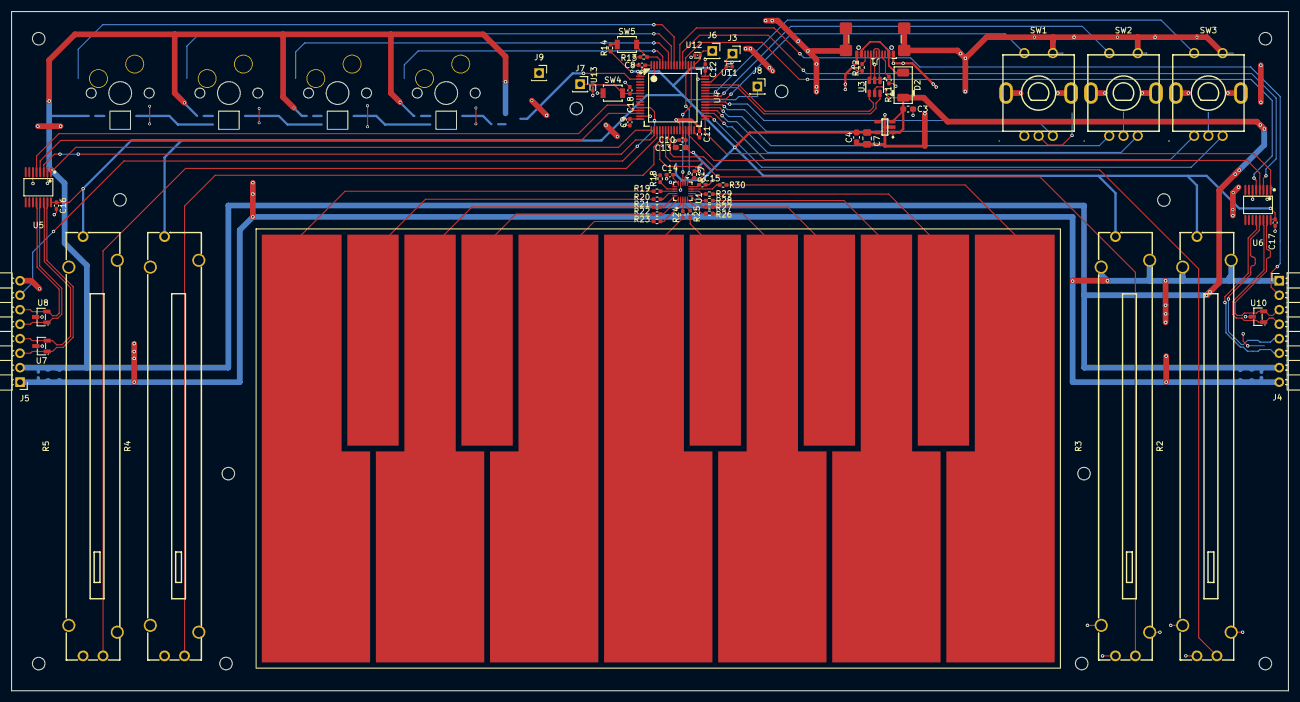
[picture p25: board Phantom Macro Mk1 MIDI.kicad_pcb from above]

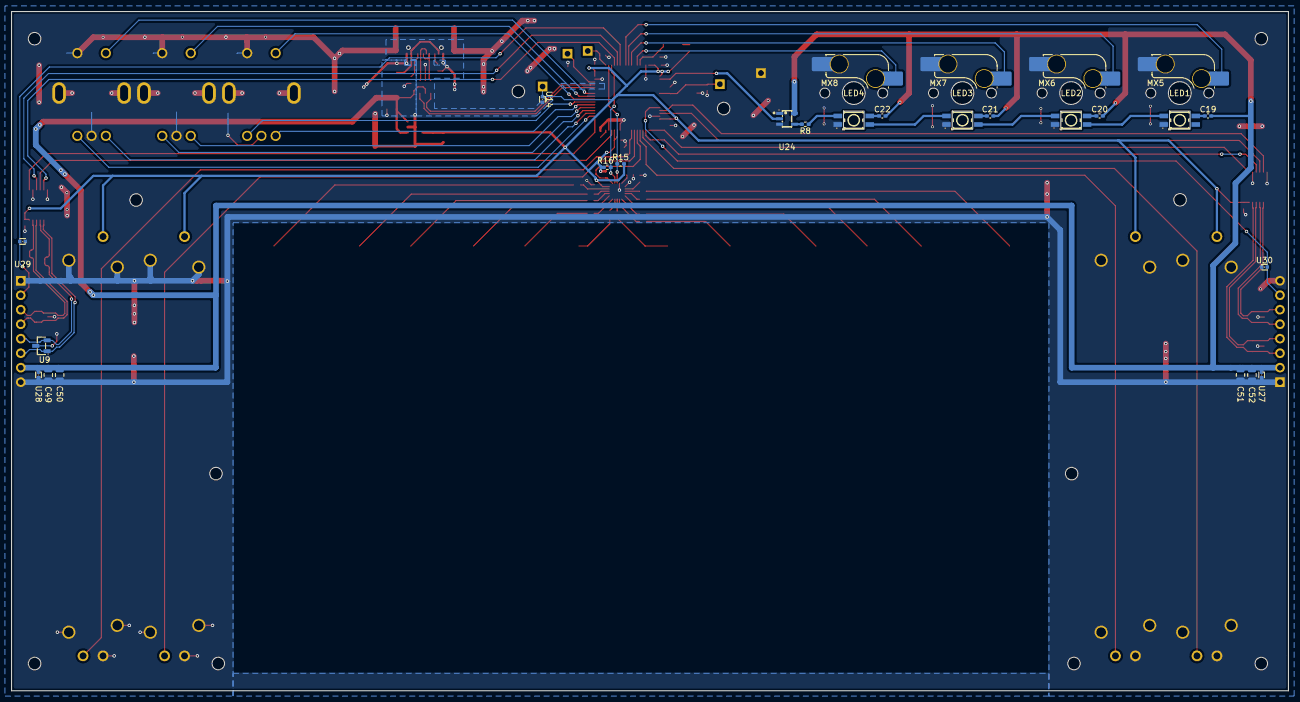
[picture p26: board Phantom Macro Mk1 MIDI.kicad_pcb from below]

Board: 2 copper layers, 223.8 x 119.1 mm, 89 parts (26 on the bottom side), 90 nets.
