thephantom8768/Phantom-Macro-Mk.1-Series/Kicad Files/Pad/Phantom Macro Mk1 Pad.kicad_pcb

## KiCad design Kicad Files/Pad/Phantom Macro Mk1 Pad.kicad_pcb (2026-11-05)

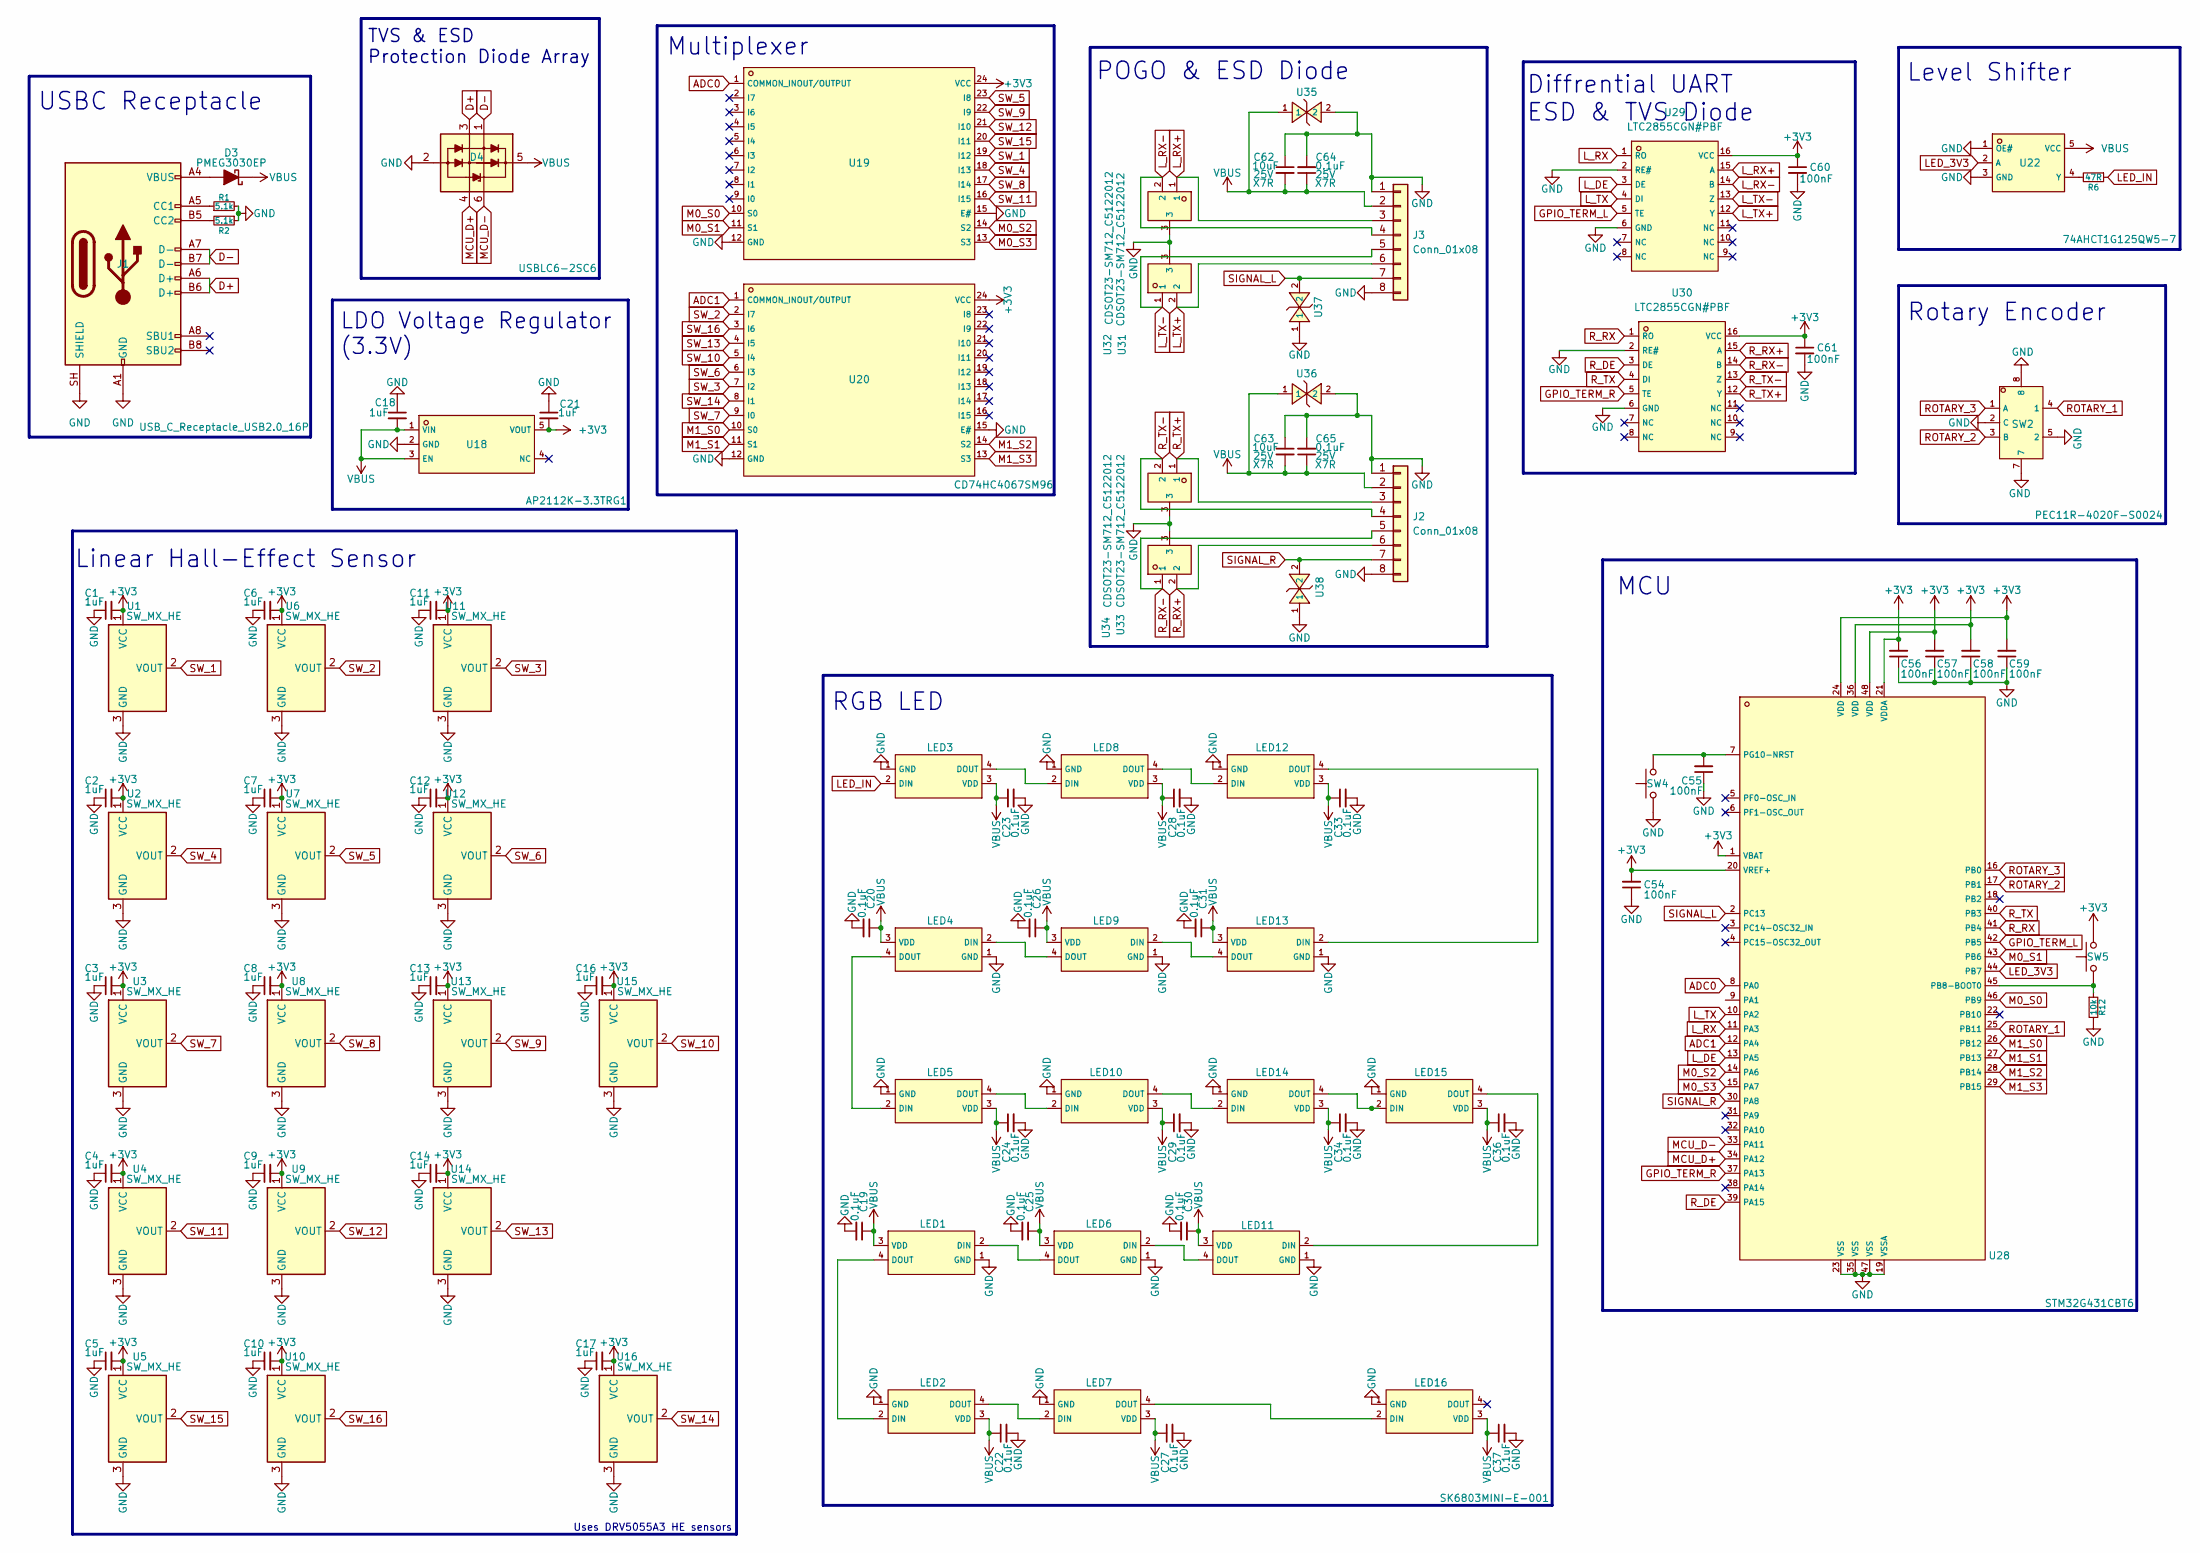
[picture p27: schematic Phantom Macro Mk1 Pad.kicad_sch]

Parts:
C1, C2, C3, C4, C5, C6, C7, C8, C9, C10, C11, C12, C13, C14, C16, C17, C18, C21: 1uF; C_0603_1608Metric_Pad1.08x0.95mm_HandSolder
C19, C20, C22, C23, C24, C25, C26, C27, C28, C29, C30, C31, C33, C34, C36, C37: 0.1uF; C_0603_1608Metric_Pad1.08x0.95mm_HandSolder
C54, C55, C56, C57, C58, C59, C60, C61: 100nF; C_0402_1005Metric_Pad0.74x0.62mm_HandSolder
C62, C63: 10uF; C_0805_2012Metric_Pad1.18x1.45mm_HandSolder; Rating 25V
C64, C65: 0.1uF; C_0805_2012Metric_Pad1.18x1.45mm_HandSolder; Rating 25V
D3: PMEG3030EP; D_SOD-128
D4: USBLC6-2SC6; SOT-23-6
J1: USB_C_Receptacle_USB2.0_16P; USB_C_Receptacle_GCT_USB4110
J2, J3: Conn_01x08; PinHeader_1x08_P2.54mm_Horizontal
LED1, LED2, LED3, LED4, LED5, LED6, LED7, LED8, LED9, LED10, LED11, LED12, LED13, LED14, LED15, LED16: SK6803MINI-E-001; C5242955_LED-SMD_4P-L3_2-W2_8_SK6803MINI-E-001; LCSC C5242955
R1, R2: 5.1k; R_0402_1005Metric_Pad0.72x0.64mm_HandSolder
R6: 47R; R_0402_1005Metric_Pad0.72x0.64mm_HandSolder
R12: 10k; R_0402_1005Metric_Pad0.72x0.64mm_HandSolder
SW2: PEC11R-4020F-S0024; C143788_SW-TH_5P-L12_5-W13_4-P2_50-LS14_5; LCSC C143788
SW4, SW5: SW_Push; SW_SPST_B3U-1000P
U1, U2, U3, U4, U5, U6, U7, U8, U9, U10, U11, U12, U13, U14, U15, U16: SW_MX_HE; Haimu Dove H V2
U18: AP2112K-3.3TRG1; C51118_SOT-25-5_L2_9-W1_6-P0_95-LS2_8-BL; LCSC C51118
U19, U20: CD74HC4067SM96; C98457_SSOP-24_L8_1-W5_3-P0_65-LS7_8-BL; LCSC C98457
U22: 74AHCT1G125QW5-7; C3755013_SOT-753_L3_1-W1_7-P0_95-LS3_0-BR; LCSC C3755013
U28: STM32G431CBT6; C529355_LQFP-48_L7_0-W7_0-P0_50-LS9_0-BL; LCSC C529355
U29, U30: LTC2855CGN#PBF; C682796_SSOP-16_L4_9-W3_9-P0_64-LS6_0-BL; LCSC C682796
U31, U32, U33, U34: CDSOT23-SM712_C5122012; C5122012_SOT-23-3_L2_9-W1_3-P0_95-LS2_4-BR; LCSC C5122012
U35, U36, U37, U38: TPD1E10B06DPYR; C48260_X1SON-2_L1_0-W0_6-P0_65-BI-1; LCSC C48260

Connections:
+3V3: C1.2, C2.2, C3.2, C4.2, C5.2, C6.2, C7.2, C8.2, C9.2, C10.2, C11.2, C12.2, C13.2, C14.2, C16.2, C17.2, C21.2, C54.2, C56.2, C57.2, C58.2, C59.2, C60.1, C61.1, SW5.2, U1.1 (VCC), U2.1 (VCC), U3.1 (VCC), U4.1 (VCC), U5.1 (VCC), U6.1 (VCC), U7.1 (VCC), U8.1 (VCC), U9.1 (VCC), U10.1 (VCC), U11.1 (VCC), U12.1 (VCC), U13.1 (VCC), U14.1 (VCC), U15.1 (VCC), U16.1 (VCC), U18.5 (VOUT), U19.24 (VCC), U20.24 (VCC), U28.1 (VBAT), U28.20 (VREF+), U28.21 (VDDA), U28.24 (VDD), U28.36 (VDD), U28.48 (VDD), U29.16 (VCC), U30.16 (VCC)
ADC0: U19.1 (COMMON_INOUT/OUTPUT), U28.8 (PA0)
ADC1: U20.1 (COMMON_INOUT/OUTPUT), U28.12 (PA4)
D+: D4.3 (L2), J1.A6 (D+), J1.B6 (D+)
D-: D4.1 (L1), J1.A7 (D-), J1.B7 (D-)
GND: C1.1, C2.1, C3.1, C4.1, C5.1, C6.1, C7.1, C8.1, C9.1, C10.1, C11.1, C12.1, C13.1, C14.1, C16.1, C17.1, C18.1, C19.2, C20.2, C21.1, C22.2, C23.2, C24.2, C25.2, C26.2, C27.2, C28.2, C29.2, C30.2, C31.2, C33.2, C34.2, C36.2, C37.2, C54.1, C55.1, C56.1, C57.1, C58.1, C59.1, C60.2, C61.2, C62.1, C63.1, C64.2, C65.2, D4.2 (VN), J1.A1 (GND), J1.A12 (GND), J1.B1 (GND), J1.B12 (GND), J1.SH (SHIELD), J2.1, J2.8, J3.1, J3.8, LED1.1 (GND), LED2.1 (GND), LED3.1 (GND), LED4.1 (GND), LED5.1 (GND), LED6.1 (GND), LED7.1 (GND), LED8.1 (GND), LED9.1 (GND), LED10.1 (GND), LED11.1 (GND), LED12.1 (GND), LED13.1 (GND), LED14.1 (GND), LED15.1 (GND), LED16.1 (GND), R1.2, R2.1, R12.2, SW2.2 (C), SW2.5 (2), SW2.7, SW2.8, SW4.1, U1.3 (GND), U2.3 (GND), U3.3 (GND), U4.3 (GND), U5.3 (GND), U6.3 (GND), U7.3 (GND), U8.3 (GND), U9.3 (GND), U10.3 (GND), U11.3 (GND), U12.3 (GND), U13.3 (GND), U14.3 (GND), U15.3 (GND), U16.3 (GND), U18.2 (GND), U19.12 (GND), U19.15 (E#), U20.12 (GND), U20.15 (E#), U22.1 (OE#), U22.3 (GND), U28.19 (VSSA), U28.23 (VSS), U28.35 (VSS), U28.47 (VSS), U29.2 (RE#), U29.6 (GND), U30.2 (RE#), U30.6 (GND), U31.3, U32.3, U33.3, U34.3, U35.2, U36.2, U37.1, U38.1
GPIO_TERM_L: U28.42 (PB5), U29.5 (TE)
GPIO_TERM_R: U28.37 (PA13), U30.5 (TE)
LED_3V3: U22.2 (A), U28.44 (PB7)
LED_IN: LED3.2 (DIN), R6.1
L_DE: U28.13 (PA5), U29.3 (DE)
L_RX: U28.11 (PA3), U29.1 (RO)
L_RX+: J3.3, U29.15 (A), U31.1
L_RX-: J3.4, U29.14 (B), U31.2
L_TX: U28.10 (PA2), U29.4 (DI)
L_TX+: J3.6, U29.12 (Y), U32.2
L_TX-: J3.5, U29.13 (Z), U32.1
M0_S0: U19.10 (S0), U28.46 (PB9)
M0_S1: U19.11 (S1), U28.43 (PB6)
M0_S2: U19.14 (S2), U28.14 (PA6)
M0_S3: U19.13 (S3), U28.15 (PA7)
M1_S0: U20.10 (S0), U28.26 (PB12)
M1_S1: U20.11 (S1), U28.27 (PB13)
M1_S2: U20.14 (S2), U28.28 (PB14)
M1_S3: U20.13 (S3), U28.29 (PB15)
MCU_D+: D4.4 (L2), U28.34 (PA12)
MCU_D-: D4.6 (L1), U28.33 (PA11)
unnamed: D3.2 (A), J1.A4 (VBUS), J1.A9 (VBUS), J1.B4 (VBUS), J1.B9 (VBUS)
unnamed: J1.A5 (CC1), R1.1
unnamed: J1.B5 (CC2), R2.2
unnamed: LED1.2 (DIN), LED6.4 (DOUT)
unnamed: LED1.4 (DOUT), LED2.2 (DIN)
unnamed: LED2.4 (DOUT), LED7.2 (DIN)
unnamed: LED3.4 (DOUT), LED8.2 (DIN)
unnamed: LED4.2 (DIN), LED9.4 (DOUT)
unnamed: LED4.4 (DOUT), LED5.2 (DIN)
unnamed: LED5.4 (DOUT), LED10.2 (DIN)
unnamed: LED10.4 (DOUT), LED14.2 (DIN)
unnamed: LED11.2 (DIN), LED15.4 (DOUT)
unnamed: LED6.2 (DIN), LED11.4 (DOUT)
unnamed: LED8.4 (DOUT), LED12.2 (DIN)
unnamed: LED12.4 (DOUT), LED13.2 (DIN)
unnamed: LED9.2 (DIN), LED13.4 (DOUT)
unnamed: LED14.4 (DOUT), LED15.2 (DIN)
unnamed: LED7.4 (DOUT), LED16.2 (DIN)
unnamed: R6.2, U22.4 (Y)
unnamed: R12.1, SW5.1, U28.45 (PB8-BOOT0)
unnamed: C55.2, SW4.2, U28.7 (PG10-NRST)
ROTARY_1: SW2.4 (1), U28.25 (PB11)
ROTARY_2: SW2.3 (B), U28.17 (PB1)
ROTARY_3: SW2.1 (A), U28.16 (PB0)
R_DE: U28.39 (PA15), U30.3 (DE)
R_RX: U28.41 (PB4), U30.1 (RO)
R_RX+: J2.6, U30.15 (A), U34.2
R_RX-: J2.5, U30.14 (B), U34.1
R_TX: U28.40 (PB3), U30.4 (DI)
R_TX+: J2.3, U30.12 (Y), U33.1
R_TX-: J2.4, U30.13 (Z), U33.2
SIGNAL_L: J3.7, U28.2 (PC13), U37.2
SIGNAL_R: J2.7, U28.30 (PA8), U38.2
SW_1: U1.2 (VOUT), U19.19 (I12)
SW_2: U6.2 (VOUT), U20.2 (I7)
SW_3: U11.2 (VOUT), U20.7 (I2)
SW_4: U2.2 (VOUT), U19.18 (I13)
SW_5: U7.2 (VOUT), U19.23 (I8)
SW_6: U12.2 (VOUT), U20.6 (I3)
SW_7: U3.2 (VOUT), U20.9 (I0)
SW_8: U8.2 (VOUT), U19.17 (I14)
SW_9: U13.2 (VOUT), U19.22 (I9)
SW_10: U15.2 (VOUT), U20.5 (I4)
SW_11: U4.2 (VOUT), U19.16 (I15)
SW_12: U9.2 (VOUT), U19.21 (I10)
SW_13: U14.2 (VOUT), U20.4 (I5)
SW_14: U16.2 (VOUT), U20.8 (I1)
SW_15: U5.2 (VOUT), U19.20 (I11)
SW_16: U10.2 (VOUT), U20.3 (I6)
VBUS: C18.2, C19.1, C20.1, C22.1, C23.1, C24.1, C25.1, C26.1, C27.1, C28.1, C29.1, C30.1, C31.1, C33.1, C34.1, C36.1, C37.1, C62.2, C63.2, C64.1, C65.1, D3.1 (K), D4.5 (VP), J2.2, J3.2, LED1.3 (VDD), LED2.3 (VDD), LED3.3 (VDD), LED4.3 (VDD), LED5.3 (VDD), LED6.3 (VDD), LED7.3 (VDD), LED8.3 (VDD), LED9.3 (VDD), LED10.3 (VDD), LED11.3 (VDD), LED12.3 (VDD), LED13.3 (VDD), LED14.3 (VDD), LED15.3 (VDD), LED16.3 (VDD), U18.1 (VIN), U18.3 (EN), U22.5 (VCC), U35.1, U36.1

Notes on the sheet:
LDO Voltage Regulator (3.3V)
RGB LED
Multiplexer
Level Shifter
MCU
Rotary Encoder
TVS & ESD Protection Diode Array
Uses DRV5055A3 HE sensors
Linear Hall-Effect Sensor
POGO & ESD Diode
Diffrential UART ESD & TVS Diode
USBC Receptacle

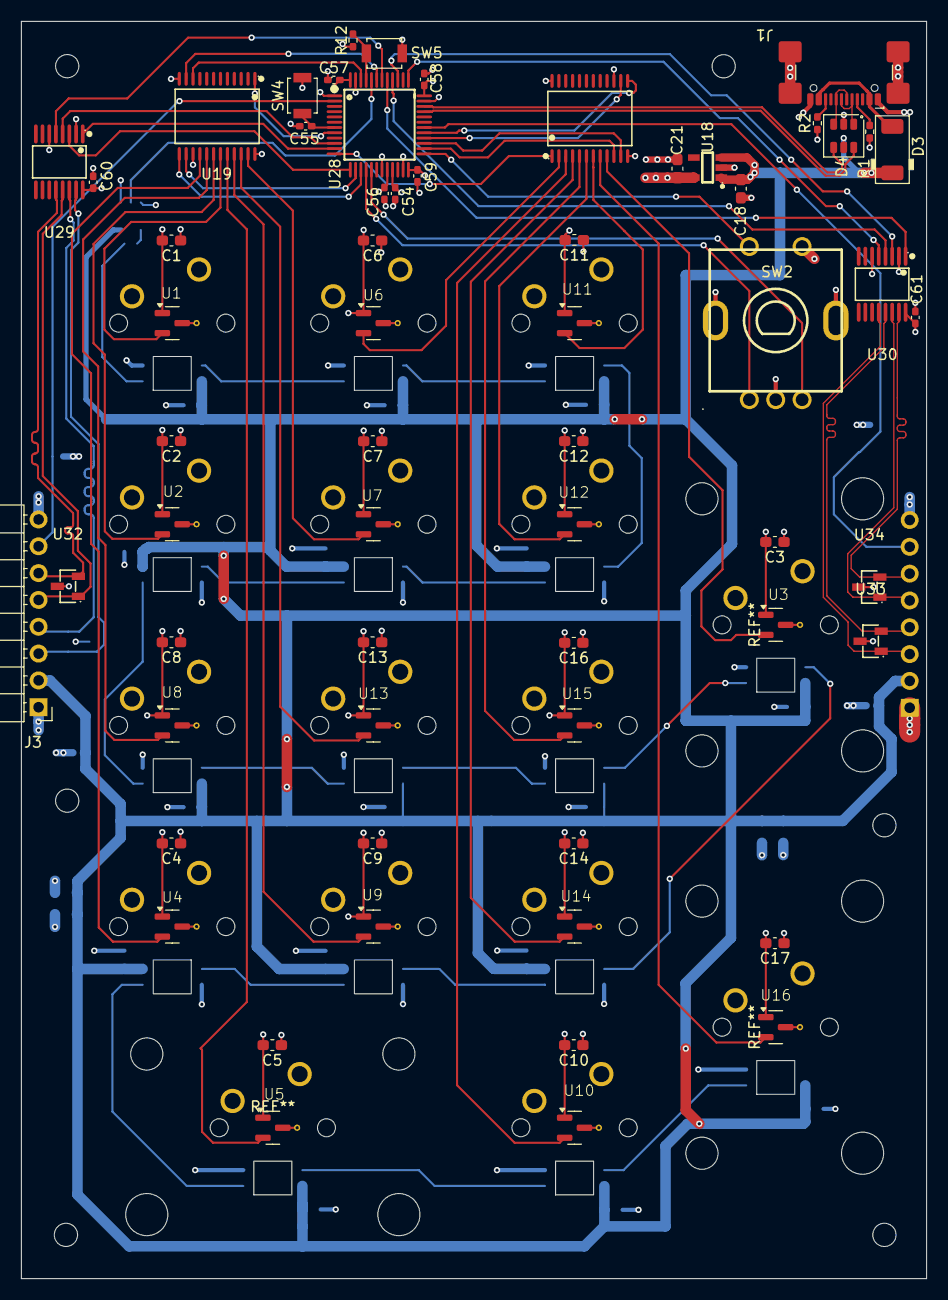
[picture p28: board Phantom Macro Mk1 Pad.kicad_pcb from above]

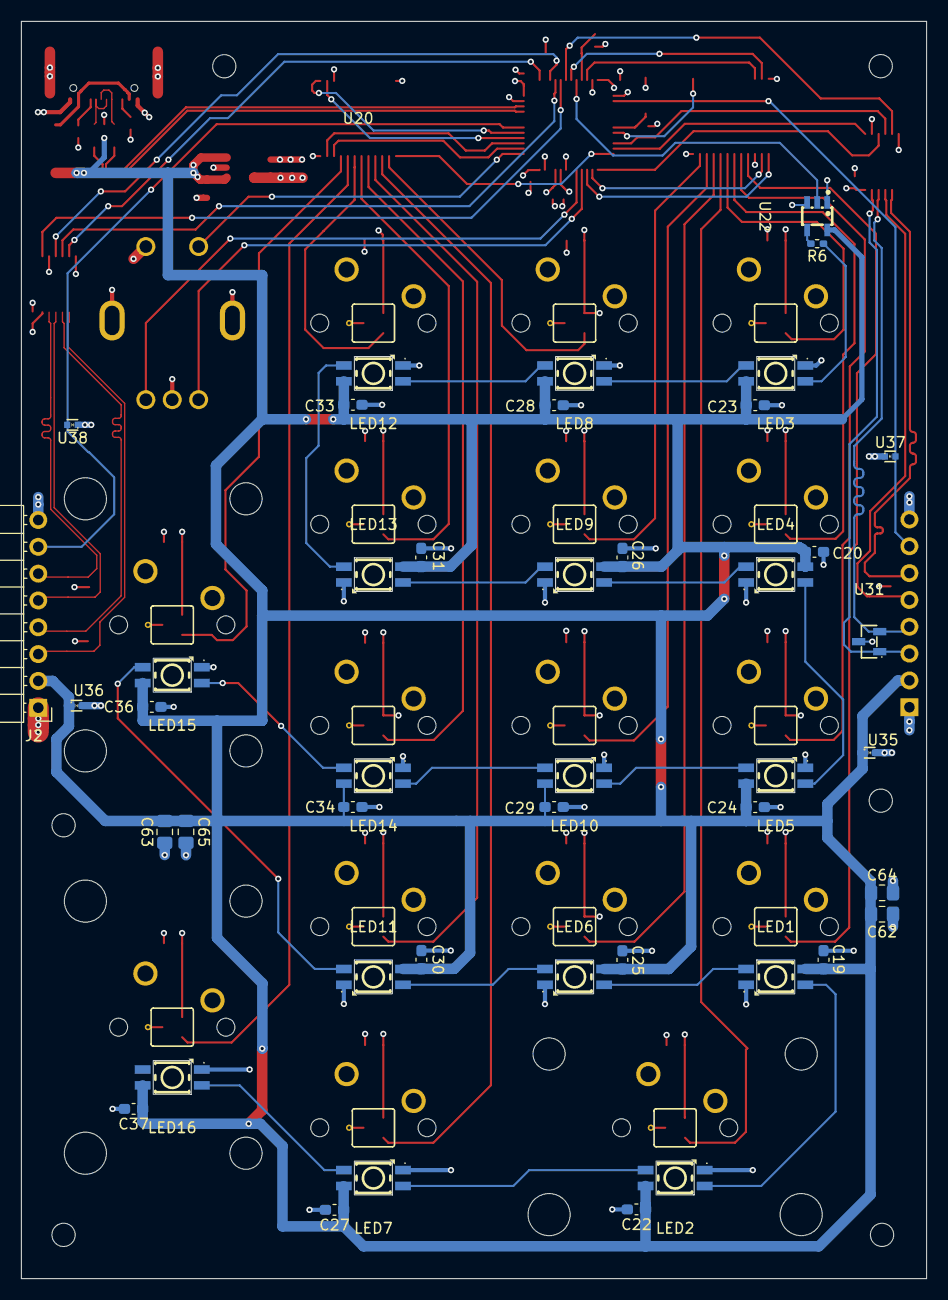
[picture p29: board Phantom Macro Mk1 Pad.kicad_pcb from below]

Board: 4 copper layers, 85.7 x 119.1 mm, 105 parts (44 on the bottom side), 77 nets.
