thephantom8768/Phantom-Macro-Mk.1-Series/(commit log)

2026-11-05 Rename Phantom Macro Mk1 Pad.csv to BOM.csv
2026-11-05 Added Pad gerber files
2026-11-05 Renamed gerber file
2026-11-10 Added & rearranged Kicad Files
